JehadMajed/DT_LINE/production_line_vision/data/calibration/calibration_top_view_20260829_140004.jpg

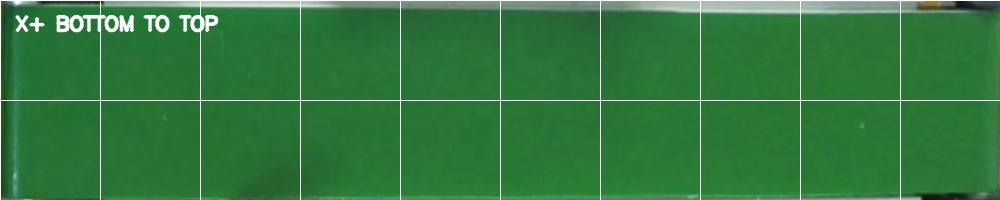
production_line_vision/data/calibration/calibration_top_view_20260829_140004.jpg
