JehadMajed/DT_LINE/Upgrades/Hardware.txt

Awaiting delivery
Date: Jun 27, 2026
Ref. Number: 1121430833916150
Copy
Details

Advanced Tech
Double BTS7960 43A H-bridge High-power Motor Driver module/smart car/
US $4.90   x1
SAR4 coupon if delayed
Free returns
Total:US $4.90
Track status
Awaiting delivery
Date: Jun 27, 2026
Ref. Number: 1121430833896150
Copy
Details

GVMRZ Store
ATC Medium Blade Waterproof Fuse Holder For Automobile 32V 18/16/14/12/10AWG Standard Fuse Insert 1A 2A 3A 4A 5A 7.5A 10A 15A-50
Black, 18AWG, 7.5A
US $2.38   x1
SAR4 coupon if delayed
Free returns
·
Door-to-door delivery
Total:US $2.38
Track status
Awaiting delivery
Date: Jun 27, 2026
Ref. Number: 1121430833876150
Copy
Details

TOP-TECH Store
ESP32 WROOM-32 Development Board WiFi+Bluetooth Ultra-Low Power Consumption for Smart Home IOT Development Board
CH340C Type C
US $6.08   x1
SAR4 coupon if delayed
Free returns
·
Door-to-door delivery
Total:US $6.08
Track status
Awaiting delivery
Date: Jun 27, 2026
Ref. Number: 1121430833856150
Copy
Details
Poder Store
JGB37-555 Miniature DC Deceleration Low Speed Motor Speed Small Motor DC 12V 24V with Speed Measuring Code Disc Encoder
12V With Bracket, 167rpm, Other
US $16.18   x1
SAR4 coupon if delayed
Free returns
Total:US $43.43
Track status
Awaiting delivery
Date: Jun 27, 2026
Ref. Number: 1121430833836150
Copy
Details

Power SMPS Specialty Store
DC 12V Power Supply 12V 5V 6V 8V 9V 12V 13V 15V 24V 1A 2A 3A 4A 5A 6A 7A 8A 10A 220V TO 12V Power Supply Adapter For LED Strips
DC 12V, 5A, EU Plug
US $11.99   x1
SAR4 coupon if delayed
Free returns
Total:US $11.99
Track status
Awaiting delivery
Date: Jun 27, 2026
Ref. Number: 1121430833816150
Copy
Details

KaiHang Electron Store
PC817 2/4/8 Channel Optocoupler Isolation Board Voltage Converter Adapter Module 3.6-30V Driver Photoelectric Isolated Module
PC817 2 Channel
US $2.47   x1
SAR4 coupon if delayed
Free returns
Total:US $2.47
Track status
Awaiting delivery
Date: Jun 27, 2026
Ref. Number: 1121430833796150
Copy
Details

Quality supplier Store
40 / 120pcs 40PIN 20CM Dupont Line Male To Male + Female And Female To Female Jumper Dupont Wire Cable For Arduino DIY KIT IBUW
KIT 120PCS
US $4.74   x1
SAR4 coupon if delayed
Free returns
·
Door-to-door delivery
Total:US $4.74
Track status
Processing
Date: Jun 27, 2026
Ref. Number: 1121430833776150
Copy
Details

Enjoying colourful life Store
Mini Conveyor Belt CNC Processing Desktop Conveyor Belt 10x50CM 555 Gear Motor Reverse with Controller for Assembly Line
US $107.41   x1
SAR4 coupon if delayed
Free returns
·
Door-to-door delivery
Total:US $107.41
Awaiting delivery
Date: Jun 27, 2026
Ref. Number: 1121430833756150
Copy
Details

SNVI Snvi Store Official Store
E3F-DS30C4 Proximity Switch Photoelectric sensor switch NPN PNP DC5-36V 30cm Detection Range Adjustable E3F-DS30P1/P2/C2/Y1
E3F-DS30C4, China Mainland
US $5.03   x1
SAR4 coupon if delayed
Free returns
