JehadMajed/DT_LINE/production_line_vision/data/calibration/baseline_artifacts_20260829_140341.png

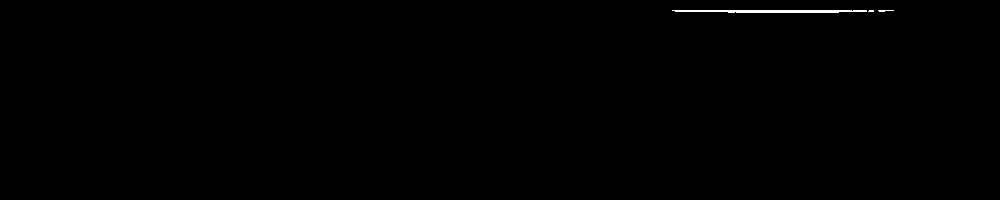
production_line_vision/data/calibration/baseline_artifacts_20260829_140341.png
