JehadMajed/DT_LINE/production_line_vision/data/calibration/baseline_empty_belt_20260829_140341.jpg

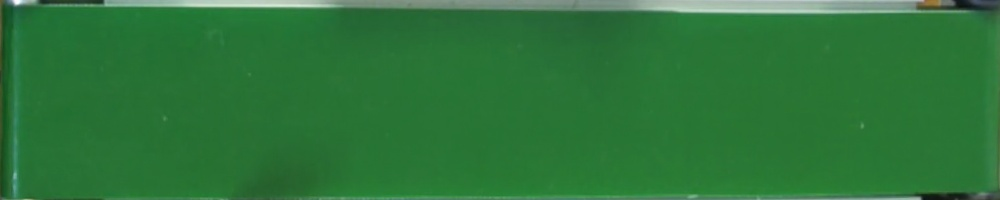
production_line_vision/data/calibration/baseline_empty_belt_20260829_140341.jpg
