JehadMajed/DT_LINE/production_line_vision/data/calibration/baseline_empty_belt_20260829_140940.jpg

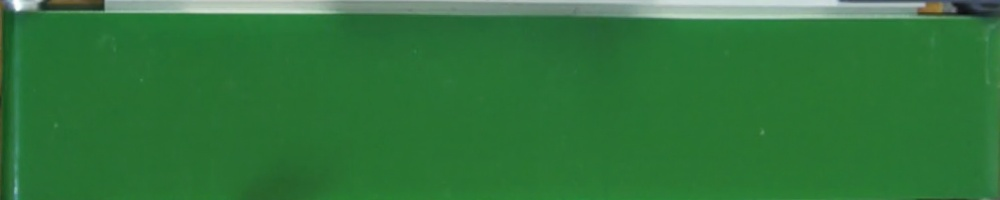
production_line_vision/data/calibration/baseline_empty_belt_20260829_140940.jpg
