JehadMajed/DT_LINE/production_line_vision/data/calibration/calibration_mask_20260829_135900.png

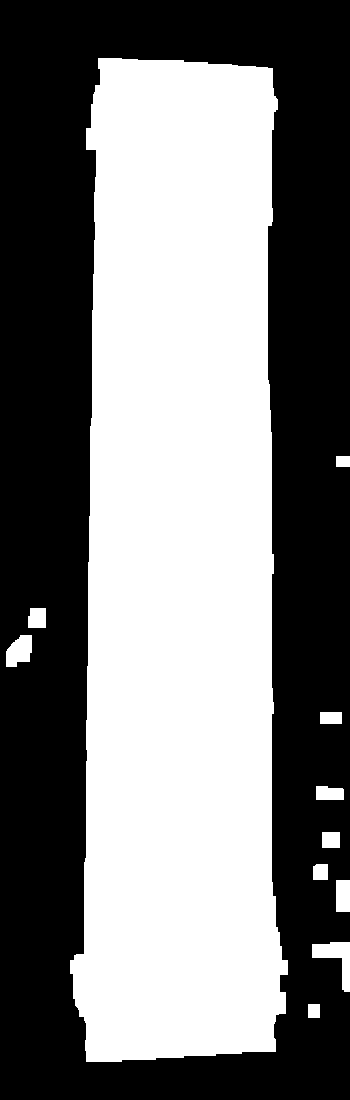
production_line_vision/data/calibration/calibration_mask_20260829_135900.png
