JehadMajed/DT_LINE/production_line_vision/data/calibration/calibration_top_view_20260829_135900.jpg

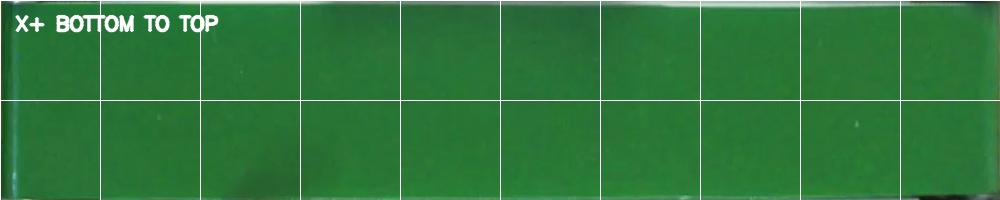
production_line_vision/data/calibration/calibration_top_view_20260829_135900.jpg
