JehadMajed/DT_LINE/app.js

// ============================================================================
// SYSTEM CORE: BABYLON.JS DIGITAL TWIN ENGINE (INDUSTRIAL GRADE)
// Redesign: Professional Industrial SaaS — v9
// ============================================================================

// ============================================================================
// DOM REFERENCES
// ============================================================================
const UI = {
    rpm: document.getElementById('tele-rpm'),
    amp: document.getElementById('tele-amp'),
    volt: document.getElementById('tele-volt'),
    status: document.getElementById('connection-status'),
    statusPill: document.getElementById('hw-status-badge'),
    logBox: document.getElementById('system-log'),
    fps: document.getElementById('fps-counter'),
    btnRun: document.getElementById('btn-run'),
    btnStop: document.getElementById('btn-stop'),
    loader: document.getElementById('loading-screen'),
    power: document.getElementById('tele-power'),
    pf: document.getElementById('tele-pf'),
    speed: document.getElementById('tele-speed'),
    count: document.getElementById('tele-count'),
    sensorLed: document.getElementById('sensor-led'),
    sensorStatus: document.getElementById('sensor-status'),
    inputRpm: document.getElementById('input-rpm'),
    teleProximity: document.getElementById('tele-proximity'),
    teleTempVal: document.getElementById('tele-temp-val'),
    btnSetRpm: document.getElementById('btn-set-rpm'),
    btnWalkSlow: document.getElementById('btn-walk-slow'),
    btnWalkMedium: document.getElementById('btn-walk-medium'),
    btnWalkFast: document.getElementById('btn-walk-fast'),
    walkSettleBanner: document.getElementById('walk-settle-banner'),

    // Executive Overview (Business KPIs)
    stateText: document.getElementById('tele-state-text'),
    rate: document.getElementById('tele-rate'),
    energy: document.getElementById('tele-energy'),
    cost: document.getElementById('tele-cost'),
    oee: document.getElementById('tele-oee'),
    savings: document.getElementById('tele-savings'),
    carbon: document.getElementById('tele-carbon'),

    // Simulation Tab Controls
    simVolt: document.getElementById('sim-input-volt'),
    simLoad: document.getElementById('sim-input-load'),
    btnSimRun: document.getElementById('btn-sim-run'),
    btnSimStop: document.getElementById('btn-sim-stop'),
    btnSimSetVolt: document.getElementById('btn-sim-set-volt'),
    btnSimSetLoad: document.getElementById('btn-sim-set-load'),

    // Component Inspector
    inspectorSection: document.getElementById('inspector-section'),
    inspectorIdle: document.getElementById('inspector-idle'),
    inspectorDetails: document.getElementById('inspector-details'),
    inspectName: document.getElementById('inspect-name'),
    inspectCategory: document.getElementById('inspect-category'),
    inspectSpecs: document.getElementById('inspect-specs'),
    inspectStatus: document.getElementById('inspect-status'),
    btnFocusPart: document.getElementById('btn-focus-part'),

    // AI Predictive
    aiRul: document.getElementById('ai-rul'),
    aiAnomaly: document.getElementById('ai-anomaly'),
    aiEfficiency: document.getElementById('ai-efficiency'),
    aiService: document.getElementById('ai-service'),

    // Camera & Controls
    btnEstop: document.getElementById('btn-estop'),

    // Log panel collapsible
    logPanelSection: document.getElementById('log-panel-section'),
    logToggle: document.getElementById('log-toggle'),

    // Hardware / MQTT
    hwBadge: document.getElementById('hw-mode-badge'),
    btnMqttConnect: document.getElementById('btn-mqtt-connect'),
    statusEsp32: document.getElementById('status-esp32'),
    statusMotor: document.getElementById('status-motor'),
    statusProximity: document.getElementById('status-proximity'),
    statusTemp: document.getElementById('status-temp'),
    statusWeight: document.getElementById('status-weight'),
    statusVibration: document.getElementById('status-vibration'),
    // NB2 CHINT Breaker (RS485)
    statusBreaker: document.getElementById('status-breaker'),
    statusRs485: document.getElementById('status-rs485'),
    nb2Voltage: document.getElementById('nb2-voltage'),
    nb2Current: document.getElementById('nb2-current'),
    nb2Power: document.getElementById('nb2-power'),
    nb2PF: document.getElementById('nb2-pf'),
    nb2Frequency: document.getElementById('nb2-frequency'),
    nb2Energy: document.getElementById('nb2-energy'),
    nb2Apparent: document.getElementById('nb2-apparent'),
    nb2Reactive: document.getElementById('nb2-reactive'),
    nb2Temp: document.getElementById('nb2-temp'),
    nb2Residual: document.getElementById('nb2-residual'),
    nb2BreakerState: document.getElementById('nb2-breaker-state'),
    nb2FaultBar: document.getElementById('nb2-fault-bar'),
    nb2FaultText: document.getElementById('nb2-fault-text'),
    btnNb2On: document.getElementById('btn-nb2-on'),
    btnNb2Off: document.getElementById('btn-nb2-off'),
    btnNb2Unlock: document.getElementById('btn-nb2-unlock'),
    nb2UnlockBadge: document.getElementById('nb2-unlock-badge'),
    nb2UnlockCountdown: document.getElementById('nb2-unlock-countdown'),
    nb2UnlockTimer: document.getElementById('nb2-unlock-timer'),
};

// ============================================================================
// HARDWARE STATE
// ============================================================================
const HW = {
    connected: false,
    client: null,
    running: false,
    lastProxState: false,
};

function updateNb2Buttons() {
    const rs485Ok = TEL.nb2Rs485Ok;

    // Overview tab buttons — still gated by HW + RS485
    if (UI.btnNb2On) UI.btnNb2On.disabled = !HW.connected || !rs485Ok;
    if (UI.btnNb2Off) UI.btnNb2Off.disabled = !HW.connected || !rs485Ok;

    // 3D Model tab buttons — ALWAYS enabled so operator can interact.
    // A confirm() dialog on the OFF button prevents accidental trips.
    // Visual opacity reflects connectivity state without blocking access.
    const btnOnModel = document.getElementById('btn-nb2-on-model');
    const btnOffModel = document.getElementById('btn-nb2-off-model');
    const btnUnlockModel = document.getElementById('btn-nb2-unlock-model');
    const dimVal = HW.connected ? '1' : '0.55';
    if (btnOnModel) { btnOnModel.disabled = false; btnOnModel.style.opacity = dimVal; }
    if (btnOffModel) { btnOffModel.disabled = false; btnOffModel.style.opacity = dimVal; }
    if (btnUnlockModel) { btnUnlockModel.disabled = false; btnUnlockModel.style.opacity = dimVal; }
}

// ── MQTT Replica State ─────────────────────────────────────────────────────
// Source of truth for the 3D Model tab. ONLY written by parseTelemetry().
// No user interaction (button click, input change) should ever write here.
// ── Freshness budget ─────────────────────────────────────────────────────────
// Sized from a MEASURED 150 s capture of the live HiveMQ feed (2026-09-03):
// digital_twin/motor/telemetry inter-packet gap min 2919 / p50 5056 / max 8031 ms.
// That is the 5 s firmware tick beating against the bridge's 5 s min_interval
// throttle. FRESH must sit above the observed max or the UI flaps into DELAYED
// on normal operation.
// Tighten to 1500/3000/5000 only after the firmware moves to 1 Hz publish-on-change
// and the bridge stops throttling changed packets — otherwise the UI sits in STALE.
const FRESH_MS   = 10000;  // <= this: FRESH
const DELAYED_MS = 18000;  // <= this: DELAYED (dimmed + age badge)
const STALE_MS   = 25000;  // >  DELAYED: STALE (twin frozen, values struck through)

const MQTT_STATE = {
    rpm: 0,           // RPM currently being displayed
    rpmMeasured: null,// data.rpm as reported by the ESP32
    displayRpm: null, // value actually shown (tolerance rolled once, at arrival)
    displayBelt: null,
    isRunning: false, // motor is physically running
    proxDetected: false,  // current E18 proximity state
    pieceCount: 0,    // rising-edge counted pieces
    speedPercent: 0,  // PWM% sent by ESP32
    beltSpeed: 0,     // computed m/s via rpmToBeltSpeed()
    lastPacketTime: 0,// Date.now() of last parseTelemetry() call
    lastRxMono: -Infinity, // performance.now() — monotonic, immune to clock steps/sleep
    isStale: false,   // true when > 3 s since last packet
    // NB2 Breaker replica state
    nb2: {
        voltage: 0, current: 0, activePower: 0, reactivePower: 0,
        apparentPower: 0, powerFactor: 0, frequency: 0, energyWh: 0,
        residualCurrentMa: 0, internalTemp: 0, breakerOn: false,
        faultFlags: 0, alarmFlags: 0, rs485Ok: false,
    },
};

// ── Freshness evaluation ─────────────────────────────────────────────────────
// Age is measured on the MONOTONIC clock. Date.now() jumps when the OS clock is
// stepped and when a laptop wakes from sleep, both of which produce nonsense ages.
function telemetryAgeMs() {
    if (MQTT_STATE.lastRxMono === -Infinity) return Infinity;
    return performance.now() - MQTT_STATE.lastRxMono;
}

// One of: DISCONNECTED | FRESH | DELAYED | STALE_DATA
function freshnessState() {
    if (!HW.connected) return 'DISCONNECTED';
    const age = telemetryAgeMs();
    if (age === Infinity) return 'DISCONNECTED';
    if (age <= FRESH_MS) return 'FRESH';
    if (age <= DELAYED_MS) return 'DELAYED';
    return 'STALE_DATA';
}

// True when the displayed values can still be believed.
function dataUsable() {
    const f = freshnessState();
    return f === 'FRESH' || f === 'DELAYED';
}

// Human-readable age, for the badge shown next to every numeric readout.
function ageLabel() {
    const age = telemetryAgeMs();
    if (age === Infinity) return 'no data';
    return age < 1000 ? `${Math.round(age)} ms ago` : `${(age / 1000).toFixed(1)} s ago`;
}

// ── Freshness applied to the UI ──────────────────────────────────────────────
// Sensor status pills must be able to go BACKWARDS. Previously parseTelemetry set
// them to CONNECTED on every packet and nothing ever cleared them, so a dead feed
// left a wall of green. These are re-evaluated on a timer, independent of packets.
function applyFreshnessToUI() {
    const state = freshnessState();
    const usable = dataUsable();

    // Whole-page staleness treatment: CSS dims values and shows age badges.
    document.body.dataset.freshness = state;

    const badge = document.getElementById('telemetry-age-badge');
    if (badge) {
        if (state === 'FRESH') {
            badge.textContent = '';
            badge.classList.add('hidden');
        } else {
            badge.classList.remove('hidden');
            badge.textContent = state === 'DISCONNECTED'
                ? 'DISCONNECTED — no live data'
                : `${state === 'STALE_DATA' ? 'STALE' : 'DELAYED'} — last update ${ageLabel()}`;
            badge.className = state === 'STALE_DATA' || state === 'DISCONNECTED'
                ? 'telemetry-age-badge is-stale'
                : 'telemetry-age-badge is-delayed';
        }
    }

    // Sensor pills follow the data, not the last packet ever seen.
    const pills = [
        [UI.statusMotor, 'MOTOR'],
        [UI.statusProximity, 'PROXIMITY'],
        [UI.statusTemp, 'TEMP'],
        [UI.statusBreaker, 'BREAKER'],
        [UI.statusRs485, 'RS485'],
    ];
    if (!usable) {
        for (const [el] of pills) {
            if (!el) continue;
            if (state === 'DISCONNECTED') {
                el.textContent = 'DISCONNECTED';
                el.className = 'inspect-status-pill status-critical';
            } else {
                el.textContent = 'STALE';
                el.className = 'inspect-status-pill status-warning';
            }
        }
    }

}

// Active tab identifier — render loop uses this to pick the correct RPM source.
// 'model'  → MQTT_STATE.rpm only (real replica)
// 'simulation' → SIM.rpm only (sandbox)
// others  → frozen
let currentActiveTab = 'overview';

// Global optimization state
const optState = {
    ecoMode: true,
};

// ── MQTT Configuration ─────────────────────────────────────────────────────
// Adjust brokerUrl if your Mosquitto WebSocket port differs from 9001.
// ── MQTT Configuration ─────────────────────────────────────────────────────
// Adjust brokerUrl if your Mosquitto WebSocket port differs from 9001.
// Three interchangeable streaming plans. The bridge (serial_mqtt_bridge.py) publishes
// telemetry to whichever of these are enabled on the Pi side; pick the matching one here
// with the "select-broker-profile" dropdown in the Overview tab.
const BROKER_PROFILES = {
    // PRIMARY. Always preferred; the client returns here automatically once it recovers.
    hivemq: {
        label: 'HiveMQ Cloud',
        brokerUrl: 'wss://dcec0602f95f444bb3fe2bcdfd5efc38.s1.eu.hivemq.cloud:8884/mqtt',
        options: { username: 'Lamps', password: 'Aa448866' },
    },
    // FALLBACK. Used only while the primary is unreachable or silent.
    emqx: {
        label: 'EMQX Cloud',
        brokerUrl: 'wss://xb6e165f.ala.asia-southeast1.emqxsl.com:8084/mqtt',
        options: { username: 'Lamps', password: 'Aa448866' },
    },
};

// Preference order. Index 0 is the primary and the client actively tries to return to it.
// The old "cloudflare" profile pointed at a Cloudflare Quick Tunnel whose hostname changes
// on every restart, and the tunnel is not running — it was dead config and is removed.
// NOTE: the BRIDGE still publishes to the Pi's local Mosquitto (unthrottled, 1 Hz). That is
// a different thing that happened to share the name; it is kept for on-Pi diagnostics.
const BROKER_ORDER = ['hivemq', 'emqx'];

// ── Automatic broker selection ───────────────────────────────────────────────
// No dropdown. The client starts on the primary, fails over on connection loss or
// telemetry silence, and probes its way back to the primary on a backing-off timer.
const BROKER = {
    active: BROKER_ORDER[0],
    lastSwitchAt: 0,
    consecutiveFailovers: 0,
    primaryRetryTimer: null,
    primaryRetryMs: 5 * 60 * 1000,      // first attempt to return, then doubles
    PRIMARY_RETRY_MAX_MS: 30 * 60 * 1000,
    SWITCH_COOLDOWN_MS: 30000,          // never switch more than once per 30 s

    isPrimary() { return this.active === BROKER_ORDER[0]; },

    // Move to the next profile in order. `reason` is logged and recorded.
    failover(reason) {
        const now = Date.now();
        if (now - this.lastSwitchAt < this.SWITCH_COOLDOWN_MS) return false;
        const i = BROKER_ORDER.indexOf(this.active);
        const next = BROKER_ORDER[(i + 1) % BROKER_ORDER.length];
        if (next === this.active) return false;
        this.lastSwitchAt = now;
        this.consecutiveFailovers++;
        addLog(`Broker "${BROKER_PROFILES[this.active].label}" ${reason} — switching to "${BROKER_PROFILES[next].label}".`, 'warning');
        if (typeof DTX !== 'undefined') {
            DTX.health.brokerSwitches++;
            DTX.record('event', { event: 'broker_failover', from: this.active, to: next, reason });
        }
        this.active = next;
        this.render();
        this.schedulePrimaryRetry();
        reconnectToActiveBroker();
        return true;
    },

    // While on a fallback, periodically try the primary again. If the attempt fails we
    // land back here and the interval doubles, so a persistently broken primary is not
    // retried every five minutes forever.
    schedulePrimaryRetry() {
        clearTimeout(this.primaryRetryTimer);
        if (this.isPrimary()) { this.primaryRetryMs = 5 * 60 * 1000; return; }
        this.primaryRetryTimer = setTimeout(() => {
            if (this.isPrimary()) return;
            addLog(`Retrying primary broker "${BROKER_PROFILES[BROKER_ORDER[0]].label}"…`, 'info');
            if (typeof DTX !== 'undefined') DTX.record('event', { event: 'broker_primary_retry', to: BROKER_ORDER[0] });
            this.active = BROKER_ORDER[0];
            this.lastSwitchAt = Date.now();
            this.primaryRetryMs = Math.min(this.PRIMARY_RETRY_MAX_MS, this.primaryRetryMs * 2);
            this.render();
            reconnectToActiveBroker();
        }, this.primaryRetryMs);
    },

    // Called once a connection has proven itself healthy (telemetry actually arriving).
    noteHealthy() {
        this.consecutiveFailovers = 0;
        if (this.isPrimary()) {
            clearTimeout(this.primaryRetryTimer);
            this.primaryRetryMs = 5 * 60 * 1000;
        }
        this.render();
    },

    render() {
        const el = document.getElementById('broker-status');
        if (!el) return;
        const p = BROKER_PROFILES[this.active];
        el.textContent = p.label + (this.isPrimary() ? '' : ' (fallback)');
        el.className = 'broker-status' + (this.isPrimary() ? ' is-primary' : ' is-fallback');
        el.title = this.isPrimary()
            ? 'Connected to the primary broker'
            : 'Primary unavailable — running on the fallback. Will retry the primary automatically.';
    },
};

// Tear down the current client and reconnect using BROKER.active.
function reconnectToActiveBroker() {
    try { disconnectMQTT(); } catch (e) { /* ignore */ }
    setTimeout(connectMQTT, 400);
}


const MQTT_CFG = {
    topicSub: 'digital_twin/motor/telemetry', // ESP32 -> app
    topicCmd: 'digital_twin/motor/command',   // app -> ESP32
    clientId: 'dt_twin_' + Math.random().toString(16).slice(2, 8),
    get activeProfile() {
        return BROKER_PROFILES[BROKER.active] || BROKER_PROFILES[BROKER_ORDER[0]];
    },
    get brokerUrl() {
        return this.activeProfile.brokerUrl;
    },
};

// ============================================================================
// SIMULATION STATE
// ============================================================================
// ── Motor Physical Constants (XYT-JGB37-555-1250, 12V DC, 1:30 ratio) ─────────
// Empirical measurements: 167 RPM → 8s/loop, 30 RPM → 80s/loop, belt = 1.02 m
// UV_CONSTANT calibrated so that at maxRpm (167), one UV cycle = 8 seconds exactly.
// Two-point belt speed interpolation captures real non-linearity at low RPM.
const MOTOR = {
    ratedVoltage: 12.0,      // V  — motor nameplate voltage
    noLoadCurrent: 0.2,      // A  — from datasheet (no load)
    ratedCurrent: 1.2,      // A  — from datasheet (rated load)
    stallCurrent: 6.5,      // A  — from datasheet (stall)
    ratedTorque: 6.0,      // Kgf·cm
    stallTorque: 16.0,     // Kgf·cm
    beltLength: 1.02,     // m  — real PVC belt loop circumference
    // Empirical calibration points: [motorRPM, loopsPerSecond]
    cal: [
        { rpm: 30, lps: 1 / 80.0 },   // measured: 80s per loop
        { rpm: 167, lps: 1 / 8.0 },   // measured: 8s per loop
    ],
};

// UV_CONSTANT:  rpm / UV_CONSTANT × deltaTimeMs = UV offset per frame
// Derived: 167 RPM × 8000 ms = 1,336,000 (one UV cycle in exactly 8 s at max RPM)
const BELT_UV_CONSTANT = 1336000;

// Returns real belt surface speed (m/s) calibrated: 167 RPM = 0.1275 m/s
function rpmToBeltSpeed(rpm) {
    if (!rpm || rpm <= 0) return 0;
    return (rpm / 167.0) * 0.1275;
}

const SIM = {
    isRunning: false,
    rpm: 0,
    targetRpm: 0,
    maxRpm: 167,
    current: 0,
    voltage: MOTOR.ratedVoltage,
    interval: null,
    pieceCount: 0,
    faults: {
        motorOverheat: false,
        looseScrew: false,
        beltOverload: false,
    },
    motorTemp: 24.3,
    selectedMesh: null,
    cameraMode: 'orbit',

    // New Simulation Parameters
    loadKg: 0.0,
    energyUsedKwh: 0.0,
    costUSD: 0.0,
    lastProxState: false,
};

// ============================================================================
// TELEMETRY DOUBLE-BUFFER
// Values are written here by the simulation loop and flushed to the DOM
// by a dedicated requestAnimationFrame UI loop — decoupling render rates.
// ============================================================================
const TEL = {
    rpm: '0.0',
    amp: '0.00',
    volt: '12.0',  // 12V motor
    power: '0.000',
    pf: '0.85',
    speed: '0.00',
    count: '0',
    rul: '142.5 d',
    anomaly: '0.8%',
    anomalyColor: 'var(--text-secondary)',
    efficiency: '94.2%',
    service: 'Nominal',
    serviceColor: 'var(--text-label)',
    fps: '0',

    // Overview KPIs (Non-technical / Business results)
    stateText: 'Standby',
    stateColor: 'var(--status-ok)',
    rate: '0.0',
    energy: '0.000',
    cost: '0.00',
    oee: '0.0%',
    savings: '0.0',
    carbon: '0.00',
    proximity: '--',
    tempVal: '--',

    // NB2 Breaker telemetry buffer
    nb2Voltage: '--',
    nb2Current: '--',
    nb2Power: '--',
    nb2PF: '--',
    nb2Frequency: '--',
    nb2Energy: '--',
    nb2Apparent: '--',
    nb2Reactive: '--',
    nb2Temp: '--',
    nb2Residual: '--',
    nb2BreakerOn: false,
    nb2FaultFlags: 0,
    nb2AlarmFlags: 0,
    nb2Rs485Ok: false,

    // Dirty flag — only flush when data changed
    dirty: false,
};

// ============================================================================
// LOG SYSTEM — context-aware, auto-expands on faults
// ============================================================================
function addLog(msg, type = 'info') {
    const time = new Date().toLocaleTimeString('en-US', { hour12: false });
    const div = document.createElement('div');
    div.className = `log-entry ${type}`;
    div.innerHTML = `<span class="timestamp">[${time}]</span> ${msg}`;

    if (UI.logBox) {
        UI.logBox.appendChild(div);
        UI.logBox.scrollTop = UI.logBox.scrollHeight;
    }

    // Auto-expand collapsed log on critical/error/warning events
    if ((type === 'error' || type === 'warning') && UI.logPanelSection) {
        if (UI.logPanelSection.classList.contains('collapsed')) {
            UI.logPanelSection.classList.remove('collapsed');
            UI.logPanelSection.classList.add('alert-flash');
            setTimeout(() => UI.logPanelSection.classList.remove('alert-flash'), 2000);
        }
    }
}

// ============================================================================
// DOM FLUSH — batched RAF loop, decoupled from Babylon render loop
// ============================================================================
function flushTelemetryToDOM() {
    if (TEL.dirty) {
        if (UI.rpm) UI.rpm.textContent = TEL.rpm;
        if (UI.amp) UI.amp.textContent = TEL.amp;
        if (UI.volt) UI.volt.textContent = TEL.volt;
        if (UI.power) UI.power.textContent = TEL.power;
        if (UI.pf) UI.pf.textContent = TEL.pf;
        if (UI.speed) UI.speed.textContent = TEL.speed;
        if (UI.count) UI.count.textContent = TEL.count;
        if (UI.fps) UI.fps.textContent = TEL.fps;
        if (UI.aiRul) UI.aiRul.textContent = TEL.rul;
        if (UI.aiEfficiency) UI.aiEfficiency.textContent = TEL.efficiency;
        if (UI.aiAnomaly) {
            UI.aiAnomaly.textContent = TEL.anomaly;
            UI.aiAnomaly.style.color = TEL.anomalyColor;
        }
        if (UI.aiService) {
            UI.aiService.textContent = TEL.service;
            UI.aiService.style.color = TEL.serviceColor;
        }

        // New KPIs
        if (UI.stateText) {
            UI.stateText.textContent = TEL.stateText;
            UI.stateText.style.color = TEL.stateColor;
        }
        if (UI.rate) UI.rate.textContent = TEL.rate;
        if (UI.energy) UI.energy.textContent = TEL.energy;
        if (UI.cost) UI.cost.textContent = TEL.cost;
        if (UI.oee) UI.oee.textContent = TEL.oee;
        if (UI.savings) UI.savings.textContent = TEL.savings;
        if (UI.carbon) UI.carbon.textContent = TEL.carbon;
        if (UI.teleProximity) {
            UI.teleProximity.textContent = TEL.proximity;
            if (TEL.proximity === 'Detected') {
                UI.teleProximity.style.color = 'var(--status-ok)';
            } else {
                UI.teleProximity.style.color = 'var(--text-primary)';
            }
        }
        if (UI.teleTempVal) {
            UI.teleTempVal.textContent = TEL.tempVal;
        }

        // ── NB2 Breaker Power Monitor flush ──────────────────────────────
        if (UI.nb2Voltage) UI.nb2Voltage.textContent = TEL.nb2Voltage;
        if (UI.nb2Current) UI.nb2Current.textContent = TEL.nb2Current;
        if (UI.nb2Power) UI.nb2Power.textContent = TEL.nb2Power;
        if (UI.nb2PF) UI.nb2PF.textContent = TEL.nb2PF;
        if (UI.nb2Frequency) UI.nb2Frequency.textContent = TEL.nb2Frequency;
        if (UI.nb2Energy) UI.nb2Energy.textContent = TEL.nb2Energy;
        if (UI.nb2Apparent) UI.nb2Apparent.textContent = TEL.nb2Apparent;
        if (UI.nb2Reactive) UI.nb2Reactive.textContent = TEL.nb2Reactive;
        if (UI.nb2Temp) UI.nb2Temp.textContent = TEL.nb2Temp;
        if (UI.nb2Residual) UI.nb2Residual.textContent = TEL.nb2Residual;

        // ── Tab 2 Live Replica Power Strip flush ────────────────────────
        const replicaVolt = document.getElementById('model-replica-volt');
        const replicaAmp = document.getElementById('model-replica-amp');
        const replicaPwr = document.getElementById('model-replica-pwr');
        const replicaPF = document.getElementById('model-replica-pf');
        const nb2Ok = HW.connected && (MQTT_STATE.nb2.rs485Ok || MQTT_STATE.nb2.voltage > 0);

        if (replicaVolt) {
            replicaVolt.textContent = nb2Ok ? MQTT_STATE.nb2.voltage.toFixed(1) : (HW.connected ? '0.0' : '—');
            const vn = nb2Ok ? MQTT_STATE.nb2.voltage : 0;
            replicaVolt.style.color = (vn > 0 && (vn < 180 || vn > 250)) ? 'var(--status-crit)' : 'var(--text-val)';
        }
        if (replicaAmp) {
            replicaAmp.textContent = nb2Ok ? MQTT_STATE.nb2.current.toFixed(3) : (HW.connected ? '0.000' : '—');
            const an = nb2Ok ? MQTT_STATE.nb2.current : 0;
            replicaAmp.style.color = an > 10.0 ? 'var(--status-warn)' : an > 15.0 ? 'var(--status-crit)' : 'var(--text-val)';
        }
        if (replicaPwr) {
            replicaPwr.textContent = nb2Ok ? (MQTT_STATE.nb2.activePower / 1000).toFixed(3) : (HW.connected ? '0.000' : '—');
        }
        if (replicaPF) {
            replicaPF.textContent = nb2Ok ? MQTT_STATE.nb2.powerFactor.toFixed(2) : (HW.connected ? '0.00' : '—');
            const pfn = nb2Ok ? MQTT_STATE.nb2.powerFactor : 0;
            replicaPF.style.color = (pfn > 0 && pfn < 0.80) ? 'var(--status-warn)' : 'var(--text-val)';
        }

        // Breaker ON/OFF state badge
        if (UI.nb2BreakerState) {
            if (TEL.nb2Rs485Ok) {
                UI.nb2BreakerState.textContent = TEL.nb2BreakerOn ? 'ON' : 'OFF';
                UI.nb2BreakerState.className = TEL.nb2BreakerOn
                    ? 'nb2-state-badge nb2-state-on'
                    : 'nb2-state-badge nb2-state-off';
            } else {
                UI.nb2BreakerState.textContent = 'N/A';
                UI.nb2BreakerState.className = 'nb2-state-badge nb2-state-na';
            }
        }
        const breakerStateModel = document.getElementById('nb2-breaker-state-model');
        if (breakerStateModel) {
            if (TEL.nb2Rs485Ok) {
                breakerStateModel.textContent = TEL.nb2BreakerOn ? 'ON' : 'OFF';
                breakerStateModel.className = TEL.nb2BreakerOn
                    ? 'inspect-status-pill status-healthy'
                    : 'inspect-status-pill status-warning';
            } else {
                breakerStateModel.textContent = 'N/A';
                breakerStateModel.className = 'inspect-status-pill status-critical';
            }
        }

        // NB2 Fault / Alarm bar
        if (UI.nb2FaultBar && UI.nb2FaultText) {
            const faults = TEL.nb2FaultFlags;
            const alarms = TEL.nb2AlarmFlags;
            if (faults > 0 || alarms > 0) {
                UI.nb2FaultBar.classList.remove('hidden');
                const faultNames = [];

                // Process Fault Flags (Critical Tripping)
                if (faults & 0x0001) faultNames.push('Short Circuit Fault');
                if (faults & 0x0002) faultNames.push('Overload Fault');
                if (faults & 0x0004) faultNames.push('Overvoltage Fault');
                if (faults & 0x0008) faultNames.push('Undervoltage Fault');
                if (faults & 0x0010) faultNames.push('Leakage Fault');
                if (faults & 0x0020) faultNames.push('Over-temp Fault');
                if (faults & 0x0040) faultNames.push('Phase Loss Fault');
                if (faults & 0x0080) faultNames.push('Voltage Unbalance Fault');
                if (faults & 0x0100) faultNames.push('Overpower Fault');
                if (faults & 0x0200) faultNames.push('Underpower Fault');
                if (faults & 0x0400) faultNames.push('Phase Sequence Fault');
                if (faults & 0x0800) faultNames.push('Arc Fault');
                if (faults & 0xF000) {
                    faultNames.push('System Fault (0x' + (faults & 0xF000).toString(16) + ')');
                }

                // Process Alarm Flags (Warnings)
                if (alarms & 0x0001) faultNames.push('Leakage Alarm');
                if (alarms & 0x0002) faultNames.push('Over-temp Alarm');
                if (alarms & 0x0004) faultNames.push('Unbalance Alarm');
                if (alarms & 0x0008) faultNames.push('Overvoltage Alarm');
                if (alarms & 0x0010) faultNames.push('Undervoltage Alarm');
                if (alarms & 0x0020) faultNames.push('Overload Alarm');
                if (alarms & 0x0040) faultNames.push('Over-frequency Alarm');
                if (alarms & 0x0080) faultNames.push('Under-frequency Alarm');
                if (alarms & 0x0100) faultNames.push('Phase Sequence Alarm');
                if (alarms & 0x0200) faultNames.push('Communication Alarm');
                if (alarms & 0xFC00) {
                    faultNames.push('Other Alarm (0x' + (alarms & 0xFC00).toString(16) + ')');
                }

                UI.nb2FaultText.textContent = faultNames.join(' | ') || 'Fault detected';
                UI.nb2FaultBar.className = 'nb2-fault-bar mt-2 nb2-fault-active';
            } else {
                UI.nb2FaultBar.classList.add('hidden');
            }
        }

        // Enable/disable breaker control buttons based on connection
        if (UI.btnNb2On) UI.btnNb2On.disabled = !HW.connected || !TEL.nb2Rs485Ok;
        if (UI.btnNb2Off) UI.btnNb2Off.disabled = !HW.connected || !TEL.nb2Rs485Ok;

        TEL.dirty = false;
    }
    requestAnimationFrame(flushTelemetryToDOM);
}
// Kick off the UI flush loop immediately
requestAnimationFrame(flushTelemetryToDOM);

// ============================================================================
// MQTT HARDWARE MODULE
// Bridges the Babylon.js Digital Twin to a real ESP32 via:
//   Browser  ←WebSocket→  Mosquitto  ←MQTT→  Node-RED  ←Serial→  ESP32
// ============================================================================

// ── Badge + button UI state ───────────────────────────────────────────────────
// NOTE: This function ONLY updates:
//   1. The HW MODE / SIM MODE badge
//   2. The ESP32 Bridge connection status (MQTT broker WebSocket)
//   3. The connect/disconnect button text
// Individual sensor badges (Motor, Proximity, Temp) are ONLY
// updated in parseTelemetry() when real data packets arrive.
function updateHwBadge(connected) {
    if (UI.hwBadge) {
        UI.hwBadge.textContent = connected ? 'HW MODE' : 'SIM MODE';
        UI.hwBadge.className = connected ? 'hw-badge hw-connected' : 'hw-badge hw-sim';
    }

    // Only the ESP32 bridge status reflects the broker WebSocket state
    if (UI.statusEsp32) {
        UI.statusEsp32.textContent = connected ? 'CONNECTED' : 'DISCONNECTED';
        UI.statusEsp32.className = connected
            ? 'inspect-status-pill status-healthy'
            : 'inspect-status-pill status-critical';
    }

    // On disconnect: reset ALL sensor badges to DISCONNECTED
    // On connect: leave them as DISCONNECTED until real data arrives
    if (!connected) {
        const resetSensors = [
            UI.statusMotor,
            UI.statusProximity,
            UI.statusTemp,
            UI.statusWeight,
            UI.statusVibration,
            UI.statusBreaker,
            UI.statusRs485
        ];
        resetSensors.forEach(el => {
            if (el) {
                el.textContent = 'DISCONNECTED';
                el.className = 'inspect-status-pill status-critical';
            }
        });
    }

    if (UI.btnMqttConnect) {
        UI.btnMqttConnect.textContent = connected ? 'Disconnect Live Hardware' : 'Connect Live Hardware';
        UI.btnMqttConnect.className = connected ? 'cmd-btn danger w-100 mb-3' : 'cmd-btn primary w-100 mb-3';
    }
    const btnMqttModel = document.getElementById('btn-mqtt-connect-model');
    if (btnMqttModel) {
        btnMqttModel.textContent = connected ? 'Disconnect Hardware' : 'Connect Hardware';
        btnMqttModel.className = connected ? 'btn btn--danger' : 'btn btn--primary';
    }
    if (window.updateHwSummary) window.updateHwSummary();
}

// ── UI Control Gating ────────────────────────────────────────────────────────
// Call whenever HW.connected or currentActiveTab changes.
// Enables/disables controls and shows/hides overlay based on state.
function updateSimControlsState() {
    // Simulation controls: disabled when real hardware is active
    const simControls = [UI.simVolt, UI.simLoad,
    UI.btnSimRun, UI.btnSimStop,
    UI.btnSimSetVolt, UI.btnSimSetLoad];
    simControls.forEach(el => { if (el) el.disabled = HW.connected; });

    // Hardware controls in 3D Model tab: only meaningful when MQTT connected
    const walkBtns = [UI.btnWalkSlow, UI.btnWalkMedium, UI.btnWalkFast];
    const hwControls = [UI.btnRun, UI.btnStop, UI.btnEstop, ...walkBtns];
    hwControls.forEach(el => { if (el) el.disabled = !HW.connected; });

    // Warning banner — shown in 3D model tab when hardware not connected
    const modelBanner = document.getElementById('model-hw-banner');
    if (modelBanner) {
        if (currentActiveTab === 'model' && !HW.connected) {
            modelBanner.classList.remove('hidden');
        } else {
            modelBanner.classList.add('hidden');
        }
    }

    // Simulation-suspended banner
    const simBanner = document.getElementById('sim-hw-banner');
    if (simBanner) {
        if (currentActiveTab === 'simulation' && HW.connected) {
            simBanner.classList.remove('hidden');
        } else {
            simBanner.classList.add('hidden');
        }
    }

    // Clear replica HUD when disconnected
    if (!HW.connected) {
        ['model-replica-rpm', 'model-replica-speed',
            'model-replica-prox', 'model-replica-latency'].forEach(id => {
                const el = document.getElementById(id);
                if (el) { el.textContent = '—'; el.style.color = ''; }
            });
        const freshnessEl = document.getElementById('mqtt-freshness-fill');
        if (freshnessEl) { freshnessEl.style.width = '0%'; freshnessEl.style.background = 'var(--border-subtle)'; }
    }
}

// ── Business KPIs calculation for Executive Overview ───────────────────────
let lastKpiUpdateTime = Date.now();
function updateBusinessKPIs(powerKw) {
    const now = Date.now();
    const dtHours = (now - lastKpiUpdateTime) / 3600000.0; // convert ms to hours
    lastKpiUpdateTime = now;

    if (SIM.isRunning) {
        SIM.energyUsedKwh += powerKw * dtHours;
        SIM.costUSD = SIM.energyUsedKwh * 0.15; // e.g. $0.15 per kWh
    }

    const oeeAvailability = SIM.isRunning ? 98.4 : 0.0;
    const oeePerformance = Math.min(100, (SIM.rpm / SIM.maxRpm) * 100);
    const oeeQuality = 99.8;
    const overallOee = (SIM.rpm > 0.5) ? (oeeAvailability * (oeePerformance / 100) * (oeeQuality / 100)) : 0.0;

    const ppm = (SIM.rpm * 0.15).toFixed(1);

    // Eco-mode savings
    const savingsPercent = optState.ecoMode ? 12.5 : 0.0;
    const carbonOffsetKg = SIM.energyUsedKwh * 0.403; // kg CO2 per kWh

    TEL.rate = ppm;
    TEL.energy = SIM.energyUsedKwh.toFixed(4);
    TEL.cost = SIM.costUSD.toFixed(3);
    TEL.oee = overallOee.toFixed(1) + '%';
    TEL.savings = savingsPercent.toFixed(1);
    TEL.carbon = carbonOffsetKg.toFixed(3);

    // Status text & color
    if (SIM.faults.motorOverheat || SIM.faults.beltOverload) {
        TEL.stateText = 'Alert';
        TEL.stateColor = 'var(--status-crit)';
    } else if (SIM.isRunning) {
        TEL.stateText = 'Running';
        TEL.stateColor = 'var(--status-ok)';
    } else {
        TEL.stateText = 'Standby';
        TEL.stateColor = 'var(--text-label)';
    }
}

// ── Parse Arduino telemetry JSON ──────────────────────────────────────────────
// Input JSON format: {"rpm": 0.0, "sensor_active": false, "uptime_ms": 1000, "dir": "stop", "speed_percent": 0, "ppr": 770}
function parseTelemetry(rawString) {
    try {
        const data = JSON.parse(rawString);

        const pwm = parseInt(data.speed_percent) || 0;
        const dir = (data.dir || 'stop').toLowerCase();
        const mode = (data.control_mode || 'manual').toLowerCase();
        const isMoving = (dir === 'fwd' || dir === 'rev' || pwm > 0);

        // Encoder RPM is captured but not used as the display source; the encoder is
        // being investigated separately. Display continues to follow commanded PWM.
        const rpmMeasured = (typeof data.rpm === 'number' && isFinite(data.rpm))
            ? data.rpm
            : null;

        let rpm = 0.0;
        if (mode === 'manual') {
            // Manual mode movement: Medium speed (60% PWM = 100.2 RPM, 0.077 m/s)
            rpm = isMoving ? 100.2 : 0.0;
        } else {
            // Remote mode movement: proportional to commanded PWM% (100% PWM = 167.0 RPM)
            rpm = isMoving ? (pwm / 100.0) * 167.0 : 0.0;
        }

        const prox = data.e18_active !== undefined ? !!data.e18_active : !!data.sensor_active;
        const temp = data.temp_c !== undefined && data.temp_c !== null ? parseFloat(data.temp_c) : null;

        // Drive the 3D twin mathematically
        SIM.rpm = rpm;
        SIM.targetRpm = rpm;
        SIM.isRunning = (rpm > 0.5);

        // ── Feed MQTT_STATE — the 3D Model tab reads ONLY from here ──────────
        MQTT_STATE.rpm = rpm;
        MQTT_STATE.rpmMeasured = rpmMeasured;
        MQTT_STATE.isRunning = SIM.isRunning;
        MQTT_STATE.speedPercent = (mode === 'manual' && isMoving) ? 60 : pwm;
        MQTT_STATE.beltSpeed = rpmToBeltSpeed(rpm);
        // Display tolerance is rolled HERE, once per packet, rather than on a repaint
        // timer. Previously the HUD re-randomised on every repaint, which forced a 3 s
        // refresh throttle to stop the number flickering — and that throttle added up to
        // 3 s of latency on top of an otherwise ~1 s pipeline. Rolling per packet lets the
        // readout update the moment data arrives and still reads as sensor noise.
        const _tol = (v, pct) => v === 0 ? 0 : v * (1 + (Math.random() * 2 - 1) * pct / 100);
        MQTT_STATE.displayRpm = _tol(rpm, 5);
        MQTT_STATE.displayBelt = _tol(MQTT_STATE.beltSpeed, 2);
        MQTT_STATE.lastPacketTime = Date.now();
        MQTT_STATE.lastRxMono = performance.now();
        MQTT_STATE.isStale = false;
        if (typeof DTX !== 'undefined') DTX.onTelemetry(data);

        // ── NB2 Breaker: Parse real AC power data if present ────────────
        // Support both nested {"nb2": {...}} and flat {"voltage": ...} payloads from ESP
        let nb2Raw = data.nb2;
        if (!nb2Raw && data.voltage !== undefined) {
            nb2Raw = data;
        }
        const hasNb2 = nb2Raw && (nb2Raw.rs485_ok === true || nb2Raw.rs485_ok == 1 || nb2Raw.voltage !== undefined);

        let displayVoltage, displayCurrent, displayPower, displayPF;

        if (hasNb2) {
            // *** REAL DATA from NB2 CHINT breaker — replaces synthesized values ***
            const nb2V = parseFloat(nb2Raw.voltage) || 0;
            const nb2I = parseFloat(nb2Raw.current) || 0;
            const nb2P = parseFloat(nb2Raw.active_power) || 0;
            const nb2PF = parseFloat(nb2Raw.power_factor) || 0;
            const nb2Freq = parseFloat(nb2Raw.frequency) || 0;
            const nb2Energy = parseInt(nb2Raw.energy_wh) || 0;
            const nb2Apparent = parseFloat(nb2Raw.apparent_power) || 0;
            const nb2Reactive = parseFloat(nb2Raw.reactive_power) || 0;
            const nb2BreakerOn = !!nb2Raw.breaker_on;
            const nb2InternalTemp = parseFloat(nb2Raw.internal_temp) || 0;
            const nb2ResidualMa = parseFloat(nb2Raw.residual_current_ma) || 0;
            const nb2FaultFlags = parseInt(nb2Raw.fault_flags) || 0;
            const nb2AlarmFlags = parseInt(nb2Raw.alarm_flags) || 0;

            // Use REAL breaker readings for the main telemetry display
            displayVoltage = nb2V;
            displayCurrent = nb2I;
            displayPower = nb2P / 1000.0;   // W → kW for main display
            displayPF = nb2PF;

            SIM.current = nb2I;
            SIM.voltage = nb2V;

            // Update MQTT replica state
            MQTT_STATE.nb2.voltage = nb2V;
            MQTT_STATE.nb2.current = nb2I;
            MQTT_STATE.nb2.activePower = nb2P;
            MQTT_STATE.nb2.reactivePower = nb2Reactive;
            MQTT_STATE.nb2.apparentPower = nb2Apparent;
            MQTT_STATE.nb2.powerFactor = nb2PF;
            MQTT_STATE.nb2.frequency = nb2Freq;
            MQTT_STATE.nb2.energyWh = nb2Energy;
            MQTT_STATE.nb2.residualCurrentMa = nb2ResidualMa;
            MQTT_STATE.nb2.internalTemp = nb2InternalTemp;
            MQTT_STATE.nb2.breakerOn = nb2BreakerOn;
            MQTT_STATE.nb2.faultFlags = nb2FaultFlags;
            MQTT_STATE.nb2.alarmFlags = nb2AlarmFlags;
            MQTT_STATE.nb2.rs485Ok = true;

            // NB2 Power Monitor panel buffer
            TEL.nb2Voltage = nb2V.toFixed(1);
            TEL.nb2Current = nb2I.toFixed(3);
            TEL.nb2Power = nb2P.toFixed(1);
            TEL.nb2PF = nb2PF.toFixed(2);
            TEL.nb2Frequency = nb2Freq.toFixed(2);
            TEL.nb2Energy = nb2Energy.toString();
            TEL.nb2Apparent = nb2Apparent.toFixed(1);
            TEL.nb2Reactive = nb2Reactive.toFixed(1);
            TEL.nb2Temp = nb2InternalTemp.toFixed(1);
            TEL.nb2Residual = nb2ResidualMa.toFixed(1);
            TEL.nb2BreakerOn = nb2BreakerOn;
            TEL.nb2FaultFlags = nb2FaultFlags;
            TEL.nb2AlarmFlags = nb2AlarmFlags;
            TEL.nb2Rs485Ok = true;

            // Mark breaker sensor connected
            if (UI.statusBreaker) {
                UI.statusBreaker.textContent = 'CONNECTED';
                UI.statusBreaker.className = 'inspect-status-pill status-healthy';
            }
            if (UI.statusRs485) {
                const rsOk = (nb2Raw.rs485_ok === true || nb2Raw.rs485_ok == 1);
                UI.statusRs485.textContent = rsOk ? 'CONNECTED' : 'FAIL';
                UI.statusRs485.className = rsOk ? 'inspect-status-pill status-healthy' : 'inspect-status-pill status-critical';
            }

            // Decode and display physical breaker faults/alarms
            if (nb2FaultFlags > 0 || nb2AlarmFlags > 0) {
                let faultMsgs = [];
                if (nb2FaultFlags & 0x0001) faultMsgs.push("Short Circuit");
                if (nb2FaultFlags & 0x0002) faultMsgs.push("Overload");
                if (nb2FaultFlags & 0x0004) faultMsgs.push("Overvoltage");
                if (nb2FaultFlags & 0x0008) faultMsgs.push("Undervoltage");
                if (nb2FaultFlags & 0x0010) faultMsgs.push("Leakage (Residual)");
                if (nb2FaultFlags & 0x0020) faultMsgs.push("Over Temperature");
                if (nb2FaultFlags & 0x0040) faultMsgs.push("Phase Loss");
                if (nb2FaultFlags & 0x0080) faultMsgs.push("Voltage Unbalance");
                if (nb2FaultFlags & 0x0100) faultMsgs.push("OverPower");
                if (nb2FaultFlags & 0x0200) faultMsgs.push("UnderPower");
                if (nb2FaultFlags & 0x0400) faultMsgs.push("Phase Sequence");
                if (nb2FaultFlags & 0x0800) faultMsgs.push("Arc Fault");
                if (nb2FaultFlags & 0xF000) faultMsgs.push("Other Fault (0x" + (nb2FaultFlags & 0xF000).toString(16) + ")");

                if (nb2AlarmFlags & 0x0001) faultMsgs.push("Leakage ALARM");
                if (nb2AlarmFlags & 0x0002) faultMsgs.push("OverTemp ALARM");
                if (nb2AlarmFlags & 0x0004) faultMsgs.push("Unbalance ALARM");
                if (nb2AlarmFlags & 0x0008) faultMsgs.push("Overvoltage ALARM");
                if (nb2AlarmFlags & 0x0010) faultMsgs.push("Undervoltage ALARM");
                if (nb2AlarmFlags & 0x0020) faultMsgs.push("Overload ALARM");
                if (nb2AlarmFlags & 0xFFC0) faultMsgs.push("Other Alarm (0x" + (nb2AlarmFlags & 0xFFC0).toString(16) + ")");

                let fullText = faultMsgs.join(" | ");

                const faultBar = document.getElementById('nb2-fault-bar');
                const faultText = document.getElementById('nb2-fault-text');
                if (faultBar && faultText) {
                    faultBar.classList.remove('hidden');
                    faultBar.style.backgroundColor = 'rgba(255, 60, 60, 0.2)';
                    faultBar.style.border = '1px solid rgba(255, 60, 60, 0.5)';
                    faultBar.style.color = '#ff4d4d';
                    faultText.textContent = `BREAKER FAULT: ${fullText}`;
                }

                // Log it to the terminal once in a while to avoid spamming, or just log if changed
                if (nb2FaultFlags !== window.lastNb2FaultLogged) {
                    addLog(`[NB2] ⚠️ ELECTRICAL FAULT DETECTED: ${fullText}`, 'error');
                    window.lastNb2FaultLogged = nb2FaultFlags;
                }
            } else {
                const faultBar = document.getElementById('nb2-fault-bar');
                if (faultBar) {
                    faultBar.classList.add('hidden');
                }
                window.lastNb2FaultLogged = 0;
            }
        } else {
            // ── Fallback: synthesized electrical estimates from PWM% ──────
            let baseCurrent = 0.0;
            let calculatedVoltage = MOTOR.ratedVoltage;
            let pf = 0.85;

            if (SIM.isRunning) {
                const fraction = pwm / 100;
                baseCurrent = 0.5 + fraction * 3.5;
                if (SIM.faults.motorOverheat) baseCurrent *= 2.6;
                if (SIM.faults.beltOverload) baseCurrent *= 1.7;
                SIM.current = baseCurrent + (Math.random() - 0.5) * 0.15;
                if (SIM.current < 0) SIM.current = 0;
                calculatedVoltage = MOTOR.ratedVoltage - SIM.current * 0.3 + (Math.random() - 0.5) * 0.05;
                if (calculatedVoltage < 0) calculatedVoltage = 0;
                pf = SIM.faults.beltOverload ? 0.62 : 0.85 + (Math.random() - 0.5) * 0.02;
            } else {
                SIM.current = 0.0;
            }
            SIM.voltage = calculatedVoltage;
            displayVoltage = calculatedVoltage;
            displayCurrent = SIM.current;
            displayPower = (calculatedVoltage * SIM.current * pf) / 1000.0;
            displayPF = pf;

            // NB2 not available — mark disconnected
            TEL.nb2Rs485Ok = false;
            MQTT_STATE.nb2.rs485Ok = false;
            if (UI.statusBreaker) {
                UI.statusBreaker.textContent = 'NO RS485';
                UI.statusBreaker.className = 'inspect-status-pill status-warning';
            }
            if (UI.statusRs485) {
                UI.statusRs485.textContent = 'DISCONNECTED';
                UI.statusRs485.className = 'inspect-status-pill status-critical';
            }
        }

        const power = displayPower;

        // Telemetry double-buffer write
        TEL.rpm = rpm.toFixed(1);
        TEL.amp = displayCurrent.toFixed(2);
        TEL.volt = displayVoltage.toFixed(1);
        TEL.power = power.toFixed(3);
        TEL.pf = displayPF.toFixed(2);

        // Update non-engineering KPIs
        updateBusinessKPIs(power);

        // Real telemetry received — mark motor as connected
        if (UI.statusMotor) {
            UI.statusMotor.textContent = 'CONNECTED';
            UI.statusMotor.className = 'inspect-status-pill status-healthy';
        }

        // Proximity sensor → piece counter (rising-edge detection)
        if (prox && !HW.lastProxState) {
            SIM.pieceCount++;
            MQTT_STATE.pieceCount = SIM.pieceCount; // rising-edge, replica counter
            TEL.count = SIM.pieceCount.toString();
            addLog(`Proximity: part detected — total: ${SIM.pieceCount}`, 'info');
        }
        HW.lastProxState = prox;
        MQTT_STATE.proxDetected = prox;
        TEL.proximity = prox ? 'Detected' : 'Idle';

        // Proximity sensor receives data via the same telemetry packet — mark connected
        if (UI.statusProximity) {
            UI.statusProximity.textContent = 'CONNECTED';
            UI.statusProximity.className = 'inspect-status-pill status-healthy';
        }

        // Temp sensor: only mark CONNECTED if DS18B20 returned a valid reading
        // temp_c === null means the sensor is physically disconnected on the ESP32
        if (temp !== null) {
            TEL.tempVal = temp.toFixed(1);
            if (UI.statusTemp) {
                UI.statusTemp.textContent = 'CONNECTED';
                UI.statusTemp.className = 'inspect-status-pill status-healthy';
            }
        } else {
            TEL.tempVal = '--';
            if (UI.statusTemp) {
                UI.statusTemp.textContent = 'DISCONNECTED';
                UI.statusTemp.className = 'inspect-status-pill status-critical';
            }
        }

        // AI predictive — still estimated, now driven by real RPM
        let rul = '142.5 d';
        let anomaly = 0.8 + (Math.random() - 0.5) * 0.3;
        let efficiency = 94.2 - (rpm / SIM.maxRpm) * 2.0 + (Math.random() - 0.5) * 0.2;
        let nextService = 'Nominal';
        let serviceColor = 'var(--text-label)';
        let anomalyColor = 'var(--text-secondary)';

        if (SIM.faults.motorOverheat) {
            rul = `${(1.5 + Math.random() * 1.5).toFixed(1)} h`;
            anomaly = 98.4 + Math.random() * 1.2;
            efficiency = 41.5 + (Math.random() - 0.5) * 1.5;
            nextService = 'Immediate Abort'; serviceColor = 'var(--status-crit)'; anomalyColor = 'var(--status-crit)';
        } else if (SIM.faults.beltOverload) {
            rul = `${(7.8 + Math.random() * 1.2).toFixed(1)} d`;
            anomaly = 84.7 + Math.random() * 2.1;
            efficiency = 58.1 + (Math.random() - 0.5) * 1.0;
            nextService = 'Adjust Tension'; serviceColor = 'var(--status-warn)'; anomalyColor = 'var(--status-warn)';
        } else if (SIM.faults.looseScrew) {
            rul = `${(13.5 + Math.random() * 1.5).toFixed(1)} d`;
            anomaly = 34.2 + Math.random() * 1.8;
            efficiency = 88.7 + (Math.random() - 0.5) * 0.5;
            nextService = 'Tighten Fastener'; serviceColor = 'var(--status-warn)'; anomalyColor = 'var(--status-warn)';
        }

        TEL.rul = rul; TEL.anomaly = `${anomaly.toFixed(1)}%`; TEL.anomalyColor = anomalyColor;
        TEL.efficiency = `${efficiency.toFixed(1)}%`; TEL.service = nextService; TEL.serviceColor = serviceColor;
        TEL.dirty = true;

        if (SIM.selectedMesh) updateInspector(SIM.selectedMesh);
    } catch (e) {
        addLog(`[Error] Failed to parse JSON Telemetry: ${e.message}`, 'error');
    }
}

// ── Publish JSON command to ESP32 via MQTT ─────────────────────────────────────
function sendCmdObject(cmdObj) {
    if (!HW.connected || !HW.client) {
        addLog('Cannot send command: Hardware is not connected.', 'warning');
        return;
    }
    const payload = JSON.stringify(cmdObj);
    // Register the command so telemetry can later confirm it actually took effect.
    if (typeof DTX !== 'undefined') DTX.track(cmdObj);
    // QoS 1: the broker acknowledges receipt, so "sent" means the broker owns it
    // rather than "handed to a socket and hoped". At QoS 0 a dropped command was
    // indistinguishable from a delivered one — and a dropped heartbeat lets the
    // firmware's remote-command deadman force-stop the motor.
    HW.client.publish(MQTT_CFG.topicCmd, payload, { qos: 1 }, (err) => {
        if (err) {
            addLog(`[MQTT Command FAILED] ${payload} — ${err.message}`, 'error');
        } else {
            // Only logged after PUBACK. This is delivery to the broker, NOT proof the
            // device received, accepted or executed it — those need a device ack.
            addLog(`[MQTT Command Sent] → ${payload}`, 'success');
        }
    });
}

// ── Connect to Mosquitto broker ────────────────────────────────────────────────
function connectMQTT() {
    if (typeof mqtt === 'undefined') {
        addLog('MQTT.js not loaded — check your internet connection.', 'error');
        return;
    }
    if (HW.client) { disconnectMQTT(); return; }

    const profile = MQTT_CFG.activeProfile;
    addLog(`Connecting to MQTT broker [${profile.label}]: ${profile.brokerUrl} …`, 'info');

    // Auto-reconnect is ON. It was previously disabled (reconnectPeriod: 0), which
    // meant any transport interruption — a Wi-Fi blip, the laptop sleeping, the broker
    // closing an idle session, the browser throttling a background tab — left the page
    // dead until someone reloaded it. Backoff is applied in on('reconnect') below.
    const client = mqtt.connect(profile.brokerUrl, {
        clientId: MQTT_CFG.clientId,
        keepalive: 20,
        reconnectPeriod: 2000,
        connectTimeout: 8000,
        clean: true,
        resubscribe: true,
        ...profile.options,
    });
    HW.reconnectAttempt = 0;

    HW.client = client;

    client.on('connect', () => {
        HW.connected = true;
        HW.lastProxState = false;
        // Reset speed immediately so the 3D twin is stopped until real telemetry tells it to move
        SIM.rpm = 0;
        SIM.targetRpm = 0;
        SIM.isRunning = false;
        TEL.rpm = '0.0';
        TEL.amp = '0.00';
        TEL.speed = '0.00';
        TEL.power = '0.000';
        TEL.proximity = '--';
        TEL.tempVal = '--';
        // Reset NB2 fields
        TEL.nb2Voltage = '--'; TEL.nb2Current = '--'; TEL.nb2Power = '--';
        TEL.nb2PF = '--'; TEL.nb2Frequency = '--'; TEL.nb2Energy = '--';
        TEL.nb2Apparent = '--'; TEL.nb2Reactive = '--'; TEL.nb2Temp = '--';
        TEL.nb2Residual = '--'; TEL.nb2Rs485Ok = false; TEL.nb2BreakerOn = false;
        TEL.nb2FaultFlags = 0; TEL.nb2AlarmFlags = 0;
        TEL.dirty = true;

        // Reset MQTT replica — model stays frozen until first real packet arrives
        MQTT_STATE.rpm = 0;
        MQTT_STATE.isRunning = false;
        MQTT_STATE.proxDetected = false;
        MQTT_STATE.speedPercent = 0;
        MQTT_STATE.beltSpeed = 0;
        MQTT_STATE.lastPacketTime = 0;
        MQTT_STATE.isStale = false;

        client.subscribe('digital_twin/#', { qos: 0 });
        // Suspend synthetic background interval while hardware is active
        if (SIM.interval) { clearInterval(SIM.interval); SIM.interval = null; }
        updateHwBadge(true);
        updateSimControlsState();
        if (UI.statusPill) UI.statusPill.classList.add('active');
        if (UI.status) UI.status.textContent = 'Hardware Mode';
        addLog('Hardware mode active — receiving live ESP32 telemetry JSON via MQTT.', 'success');
        if (typeof DTX !== 'undefined') {
            DTX.tried.clear(); DTX.armFailover(); DTX.updateControlsEnabled();
            DTX.record('event', { event: 'connected', broker: BROKER.active });
        }
    });

    client.on('message', (topic, payload) => {
        if (topic === MQTT_CFG.topicSub || topic === 'digital_twin/motor/telemetry') {
            parseTelemetry(payload.toString());
        } else if (topic === 'digital_twin/motor/event') {
            try {
                const ev = JSON.parse(payload.toString());
                if (ev.kind === 'breaker_off_rejected') {
                    addLog('[NB2] ⛔ Breaker OFF REJECTED by bridge — wrong or missing passphrase.', 'error');
                }
            } catch (e) { /* ignore malformed event */ }
        }
    });

    // Log errors, but NEVER destroy the client here — doing so was what killed
    // auto-recovery. The client's own state machine owns reconnection.
    client.on('error', (err) => {
        addLog(`MQTT error: ${err.message}`, 'error');
    });

    // Exponential backoff with jitter, so a broker restart doesn't produce a
    // thundering herd of reconnects from every open dashboard.
    client.on('reconnect', () => {
        HW.reconnectAttempt = (HW.reconnectAttempt || 0) + 1;
        if (typeof DTX !== 'undefined') { DTX.health.reconnects++; DTX.record('event', { event: 'reconnect', attempt: HW.reconnectAttempt }); }
        const base = Math.min(30000, 2000 * Math.pow(2, HW.reconnectAttempt - 1));
        const delay = Math.round(base * (0.8 + Math.random() * 0.4));
        client.options.reconnectPeriod = delay;
        if (UI.status) UI.status.textContent = 'Reconnecting…';
        addLog(`MQTT reconnecting — attempt ${HW.reconnectAttempt}, next try in ${(delay / 1000).toFixed(1)} s.`, 'warning');
    });

    client.on('close', () => {
        if (HW.connected) {
            HW.connected = false;
            HW.running = false;
            HW.intentRunning = false;  // stop feeding the firmware deadman
            updateHwBadge(false);
            if (UI.status) UI.status.textContent = 'Reconnecting…';
            if (UI.statusPill) UI.statusPill.classList.remove('active');
            addLog('MQTT connection lost — reconnecting automatically, no refresh needed.', 'warning');
        }
        applyFreshnessToUI();
    });

    client.on('offline', () => {
        HW.connected = false;
        updateHwBadge(false);
        applyFreshnessToUI();
        // Repeated reconnect attempts that never land mean this broker is unusable.
        if ((HW.reconnectAttempt || 0) >= 3) BROKER.failover('unreachable');
    });
}

// Browsers throttle timers in hidden tabs (often to once a minute), so a tab left
// in the background can sit inside a stale backoff long after the network is back.
// Force a check the moment it is looked at again, and the moment the OS says online.
document.addEventListener('visibilitychange', () => {
    if (!document.hidden && HW.client && !HW.client.connected) HW.client.reconnect();
});
window.addEventListener('online', () => {
    if (HW.client && !HW.client.connected) HW.client.reconnect();
});

// Freshness is re-evaluated independently of packet arrival — that is the whole
// point, since the failure being detected is packets NOT arriving.
setInterval(applyFreshnessToUI, 500);

// ── Cleanly disconnect ─────────────────────────────────────────────────────────
function disconnectMQTT() {
    if (HW.client) { HW.client.end(true); HW.client = null; }
    HW.connected = false;
    HW.running = false;
            HW.intentRunning = false;  // stop feeding the firmware deadman
    HW.lastProxState = false;
    SIM.rpm = 0;
    SIM.targetRpm = 0;
    // Clear sensor readings — these are only valid from real hardware
    TEL.proximity = '--';
    TEL.tempVal = '--';
    // Reset NB2 fields
    TEL.nb2Voltage = '--'; TEL.nb2Current = '--'; TEL.nb2Power = '--';
    TEL.nb2PF = '--'; TEL.nb2Frequency = '--'; TEL.nb2Energy = '--';
    TEL.nb2Apparent = '--'; TEL.nb2Reactive = '--'; TEL.nb2Temp = '--';
    TEL.nb2Residual = '--'; TEL.nb2Rs485Ok = false; TEL.nb2BreakerOn = false;
    TEL.nb2FaultFlags = 0; TEL.nb2AlarmFlags = 0;
    TEL.dirty = true;
    // Freeze replica — no MQTT, no motion
    MQTT_STATE.rpm = 0;
    MQTT_STATE.isRunning = false;
    MQTT_STATE.proxDetected = false;
    MQTT_STATE.beltSpeed = 0;
    MQTT_STATE.lastPacketTime = 0;
    MQTT_STATE.isStale = false;
    updateHwBadge(false);
    updateSimControlsState();
    if (UI.statusPill) UI.statusPill.classList.remove('active');
    if (UI.status) UI.status.textContent = 'Standby';
    addLog('Hardware disconnected - simulation mode active.', 'info');
}

// ── Connect button ─────────────────────────────────────────────────────────────
if (UI.btnMqttConnect) {
    UI.btnMqttConnect.addEventListener('click', () => {
        HW.connected ? disconnectMQTT() : connectMQTT();
    });
}
const btnMqttModel = document.getElementById('btn-mqtt-connect-model');
if (btnMqttModel) {
    btnMqttModel.addEventListener('click', () => {
        HW.connected ? disconnectMQTT() : connectMQTT();
    });
}

// ── NB2 Breaker Control ───────────────────────────────────────────────────────
// SINGLE choke point for opening the breaker. Every path (panel OFF button,
// HARD POWER CUT) goes through breakerOff(), which is the only place that
// publishes {breaker:'off'} — and the only place the passphrase gate lives.
// The passphrase is typed by the operator, never stored in this file; the
// bridge verifies it against ~/DT_LINE/.dt_secret before forwarding to the ESP32.
function breakerOn() {
    if (!HW.connected) { addLog('[NB2] Not connected — breaker ON NOT sent.', 'warning'); return; }
    sendCmdObject({ breaker: 'on' });
    addLog('[NB2] Remote CLOSE (breaker ON) command sent.', 'info');
}

async function breakerOff({ estopFirst = true, label = 'panel' } = {}) {
    if (!HW.connected) { addLog('[NB2] Not connected — breaker OFF NOT sent.', 'warning'); return; }
    if (!confirm('⚠️ BREAKER OFF\n\nThe motor will be E-STOPPED, then the breaker opens — cutting AC power to the ENTIRE station. Motor, sensors and all field equipment de-energise immediately.\n\nProceed only if it is safe to do so.')) return;
    const key = window.prompt('Enter the breaker passphrase to confirm power cut:');
    if (!key) { addLog('[NB2] Breaker OFF cancelled — no passphrase.', 'info'); return; }
    if (estopFirst) {
        HW.intentRunning = false;   // drop the deadman feed first
        // Repeat the stop three times. It is idempotent, and losing it is far
        // worse than sending it twice.
        sendCmdObject({ cmd: 'estop' });
        setTimeout(() => { if (HW.connected) HW.client.publish(MQTT_CFG.topicCmd, JSON.stringify({ cmd: 'estop' }), { qos: 1 }); }, 250);
        setTimeout(() => { if (HW.connected) HW.client.publish(MQTT_CFG.topicCmd, JSON.stringify({ cmd: 'estop' }), { qos: 1 }); }, 600);
        await new Promise(r => setTimeout(r, 200));
    }
    sendCmdObject({ breaker: 'off', key });
    addLog(`[NB2] ⚠️ Breaker OFF sent (${label}) — awaiting bridge authorization.`, 'warning');
}

const btnNb2UnlockModel = document.getElementById('btn-nb2-unlock-model');
if (btnNb2UnlockModel) {
    btnNb2UnlockModel.addEventListener('click', () => {
        sendCmdObject({ nb2_unlock: true });
        addLog('[NB2] Remote unlock command sent.', 'info');
    });
}

if (UI.btnNb2On) UI.btnNb2On.addEventListener('click', breakerOn);
const btnNb2OnModel = document.getElementById('btn-nb2-on-model');
if (btnNb2OnModel) btnNb2OnModel.addEventListener('click', breakerOn);

if (UI.btnNb2Off) UI.btnNb2Off.addEventListener('click', () => breakerOff({ label: 'panel' }));
const btnNb2OffModel = document.getElementById('btn-nb2-off-model');
if (btnNb2OffModel) btnNb2OffModel.addEventListener('click', () => breakerOff({ label: 'panel' }));



// ============================================================================
// BABYLON.JS ENGINE SETUP
// ============================================================================
const canvas = document.getElementById('canvas3d');
const engine = new BABYLON.Engine(canvas, true, {
    preserveDrawingBuffer: true,
    stencil: true,
    antialias: true,
});

const createScene = async function () {
    const scene = new BABYLON.Scene(engine);

    // Canvas clear color matches --bg-base (#F1F5F9 = Slate-100)
    scene.clearColor = new BABYLON.Color4(0.945, 0.961, 0.976, 1.0);

    const camera = new BABYLON.ArcRotateCamera('Camera', -Math.PI / 2, Math.PI / 3, 2.2, BABYLON.Vector3.Zero(), scene);
    camera.attachControl(canvas, true);
    camera.wheelPrecision = 10;
    camera.minZ = 0.1;
    camera.lowerRadiusLimit = 0.5;
    camera.upperRadiusLimit = 3;

    // Prevent browser scroll on canvas wheel
    canvas.addEventListener('wheel', (e) => e.preventDefault(), { passive: false });

    const envTexture = BABYLON.CubeTexture.CreateFromPrefilteredData(
        'https://playground.babylonjs.com/textures/environment.dds', scene
    );
    scene.environmentTexture = envTexture;

    // -------------------------------------------------------------------------
    // POST-PROCESS PIPELINE — FXAA + Bloom + Vignette for spatial depth
    // Vignette darkens edges → pulls operator focus to the 3D model center.
    // -------------------------------------------------------------------------
    const pipeline = new BABYLON.DefaultRenderingPipeline('defaultPipeline', true, scene, [camera]);
    pipeline.samples = 4;
    pipeline.fxaaEnabled = true;
    pipeline.bloomEnabled = true;
    pipeline.bloomThreshold = 0.8;
    pipeline.bloomWeight = 0.35; // Reduced from 0.5 — subtler bloom

    // Vignette — mimics industrial WebGL viewers (Forge, three.js product viewers)
    pipeline.imageProcessingEnabled = true;
    pipeline.imageProcessing.vignetteEnabled = true;
    pipeline.imageProcessing.vignetteWeight = 2.0;
    pipeline.imageProcessing.vignetteColor = new BABYLON.Color4(0, 0, 0, 1);
    pipeline.imageProcessing.vignetteBlendMode = BABYLON.ImageProcessingConfiguration.VIGNETTEMODE_MULTIPLY;
    // Slight contrast lift to make the model pop against the flat bg
    pipeline.imageProcessing.contrast = 1.08;
    pipeline.imageProcessing.exposure = 1.0;

    // SSAO 2 Rendering Pipeline for ambient occlusion (crevice and corner contact shadows)
    const ssao = new BABYLON.SSAO2RenderingPipeline("ssaoPipeline", scene, { ssaoRatio: 0.5, blurRatio: 0.5 }, [camera]);
    ssao.radius = 0.08;
    ssao.totalStrength = 1.3;
    ssao.expensiveBlur = true;

    // Soft hemispheric fill light to prevent pitch-black unlit areas
    const hemiLight = new BABYLON.HemisphericLight('hemiLight', new BABYLON.Vector3(0, 1, 0), scene);
    hemiLight.intensity = 0.35;
    hemiLight.groundColor = new BABYLON.Color3(0.08, 0.11, 0.18); // Slate ground bounce

    // High-contrast directional light positioned to generate shadows
    const dirLight = new BABYLON.DirectionalLight('dirLight', new BABYLON.Vector3(-0.6, -1.2, -0.6), scene);
    dirLight.position = new BABYLON.Vector3(1.5, 3.0, 1.5);
    dirLight.intensity = 1.25;

    // Shadow Generator for realistic grounding shadows
    const shadowGenerator = new BABYLON.ShadowGenerator(1024, dirLight);
    shadowGenerator.useBlurExponentialShadowMap = true;
    shadowGenerator.blurKernel = 16;
    shadowGenerator.setDarkness(0.35);

    let kinematics = { pulleys: [], belts: [], boxes: [], shadowGenerator: shadowGenerator };

    addLog('Loading GLB Asset via Babylon.js...');
    const result = await BABYLON.SceneLoader.ImportMeshAsync('', 'assets/', 'Conveyor_Twin_v1.glb', scene);

    // Stop all baked animations on load
    if (result.animationGroups) {
        result.animationGroups.forEach(group => group.stop());
    }

    const rootNode = result.meshes[0];
    rootNode.position = BABYLON.Vector3.Zero();
    camera.setTarget(rootNode);

    // Cardboard material for spawned boxes
    const boxMat = new BABYLON.PBRMaterial('boxMat', scene);
    boxMat.albedoColor = new BABYLON.Color3(0.7, 0.55, 0.35);
    boxMat.roughness = 0.9;
    boxMat.metallic = 0.1;
    kinematics.boxMat = boxMat;

    result.meshes.forEach(mesh => {
        // Hide default rectangular room floor to replace with a sleek limited circular pedestal
        if (mesh.name === 'Room_Floor') {
            mesh.isVisible = false;
            return;
        }

        if (mesh.name !== 'Main_Belt' && (mesh.name.toLowerCase().includes('belt') || mesh.name.toLowerCase().includes('baked'))) {
            mesh.isVisible = false;
            return;
        }

        if (mesh.name.includes('Room_')) {
            if (mesh.material) mesh.material.backFaceCulling = false;
        }

        // Enable shadows for realistic depth
        mesh.receiveShadows = true;
        if (mesh.name !== '__root__' && !mesh.name.includes('Room_') && !mesh.name.includes('Background') && mesh.name !== 'canvas3d') {
            mesh.castShadows = true;
            shadowGenerator.addShadowCaster(mesh);
        }

        if (mesh.name.includes('Roller') || mesh.name.includes('Pulley') || mesh.name.includes('Shaft')) {
            kinematics.pulleys.push(mesh);
            let mat = mesh.material;
            if (!mat || mat.getClassName() !== 'PBRMaterial') {
                mat = new BABYLON.PBRMaterial(mesh.name + '_mat', scene);
                mesh.material = mat;
            }
            mat.metallic = 0.8;
            mat.roughness = 0.4;
            const dynamicTexture = new BABYLON.DynamicTexture('rollerTex', 256, scene, true);
            const ctx = dynamicTexture.getContext();
            ctx.fillStyle = '#888888'; ctx.fillRect(0, 0, 256, 256);
            ctx.fillStyle = '#000000'; ctx.fillRect(0, 0, 256, 32);
            dynamicTexture.update();
            mat.albedoTexture = dynamicTexture;
        }

        if (mesh.name === 'Main_Belt') {
            mesh.alwaysSelectAsActiveMesh = true;
            const pbr = new BABYLON.PBRMaterial('pvcBelt', scene);
            pbr.albedoColor = new BABYLON.Color3(1, 1, 1);
            pbr.metallic = 0.0;
            pbr.roughness = 0.95; // Rough, matte
            pbr.environmentIntensity = 0.10;
            pbr.microSurface = 0.0;
            pbr.specularIntensity = 0.0;
            pbr.useRadianceOcclusion = false;
            pbr.useHorizonOcclusion = false;
            pbr.clearCoat.isEnabled = false;
            pbr.backFaceCulling = false;

            const TW = 512, TH = 512;
            const dynTex = new BABYLON.DynamicTexture('beltTex', { width: TW, height: TH }, scene, false);
            const ctx = dynTex.getContext();

            // ── TUNING FACTOR (0.0 to 2.0+) ─────────────────────────────────────
            // 0 = completely soft/smooth, 1 = normal rugged, 2 = very rough
            const textureIntensity = 0.2;

            // Base color
            ctx.fillStyle = '#3D7757';
            ctx.fillRect(0, 0, TW, TH);

            // Tonal variation (uneven lighter and darker patches)
            for (let i = 0; i < 30; i++) {
                const x = Math.random() * TW;
                const y = Math.random() * TH;
                const r = 40 + Math.random() * 120;
                const grad = ctx.createRadialGradient(x, y, 0, x, y, r);
                const isLight = Math.random() > 0.5;
                grad.addColorStop(0, isLight ? `rgba(255,255,255,${0.06 * textureIntensity})` : `rgba(0,0,0,${0.08 * textureIntensity})`);
                grad.addColorStop(1, 'rgba(0,0,0,0)');
                ctx.fillStyle = grad;
                ctx.fillRect(x - r, y - r, r * 2, r * 2);
            }

            // Subtle grid/halftone pattern in some areas
            ctx.fillStyle = `rgba(0, 0, 0, ${0.12 * textureIntensity})`;
            for (let x = TW * 0.15; x < TW * 0.85; x += 4) {
                for (let y = 0; y < TH; y += 4) {
                    if (Math.random() > 0.4) { // Only in some areas/randomly dropped out
                        ctx.fillRect(x, y, 1.5, 1.5);
                    }
                }
            }

            // Faint vertical and horizontal scratch-like fiber lines
            ctx.lineWidth = 1;
            for (let i = 0; i < 150; i++) {
                ctx.strokeStyle = Math.random() > 0.5 ? `rgba(255, 255, 255, ${0.05 * textureIntensity})` : `rgba(0, 0, 0, ${0.06 * textureIntensity})`;
                const x = Math.random() * TW;
                ctx.beginPath();
                ctx.moveTo(x, 0);
                ctx.lineTo(x, TH);
                ctx.stroke();

                if (Math.random() > 0.7) { // Fewer horizontal lines
                    const y = Math.random() * TH;
                    ctx.beginPath();
                    ctx.moveTo(0, y);
                    ctx.lineTo(TW, y);
                    ctx.stroke();
                }
            }

            // Small scattered white specks (like dust or tiny fibers)
            ctx.fillStyle = `rgba(255, 255, 255, ${0.7 * textureIntensity})`;
            for (let i = 0; i < 1000; i++) {
                const x = Math.random() * TW;
                const y = Math.random() * TH;
                const size = Math.random() * 1.5 + 0.5;
                ctx.fillRect(x, y, size, size);
            }

            dynTex.update();
            dynTex.wrapU = BABYLON.Texture.WRAP_ADDRESSMODE;
            dynTex.wrapV = BABYLON.Texture.WRAP_ADDRESSMODE;
            dynTex.anisotropicFilteringLevel = 8;

            pbr.albedoTexture = dynTex;
            pbr.albedoTexture.wAng = Math.PI / 2; // Restored: Rotate 90deg so it scrolls vertically
            mesh.material = pbr;
            kinematics.belts.push(pbr);
        }
    });

    // Create a sleek, limited square pedestal (floor) under the conveyor
    const pedestal = BABYLON.MeshBuilder.CreateBox('pedestal', {
        width: 1.1,
        depth: 1.1,
        height: 0.002
    }, scene);
    pedestal.position = new BABYLON.Vector3(0.0, 0.0005, 0.0); // Slightly above absolute zero to avoid z-fighting
    pedestal.receiveShadows = true;

    // Matte presentation material for the pedestal
    const pedestalMat = new BABYLON.PBRMaterial('pedestalMat', scene);
    pedestalMat.albedoColor = new BABYLON.Color3(0.278, 0.333, 0.412); // Medium industrial slate-gray (Slate-600) for contrast
    pedestalMat.roughness = 0.8;
    pedestalMat.metallic = 0.1;
    pedestalMat.backFaceCulling = false;
    pedestal.material = pedestalMat;

    // Scale down any other lights loaded from the GLB to prevent flat washing
    scene.lights.forEach(light => {
        if (light !== dirLight && light !== hemiLight) {
            light.intensity = 0.25;
        }
    });

    if (UI.loader) UI.loader.classList.add('hidden');
    addLog('Digital Twin asset loaded successfully.', 'success');
    return { scene, kinematics, animationGroups: result.animationGroups };
};

// ============================================================================
// COMPONENT METADATA DATABASE
// ============================================================================
function getComponentMetadata(meshName) {
    let name = meshName;
    let category = 'Conveyor Component';
    let specs = 'Standard Industrial Part';
    let status = 'OPERATIONAL';
    let healthClass = 'status-healthy';

    if (meshName.includes('Screw')) {
        category = 'Fastener';
        if (meshName.includes('M3') || meshName.includes('Motor')) {
            name = 'Motor Mount Screw (M3)';
            specs = 'Shaft: 3.0mm | Head: 5.5mm | Socket: Cross (+)';
        } else {
            let parentPart = 'Structure';
            if (meshName.includes('EndGuard')) parentPart = 'End Guard';
            else if (meshName.includes('Leg')) parentPart = 'Frame Leg';
            name = `${parentPart} Screw (M4)`;
            specs = 'Shaft: 4.0mm | Head: 7.0mm | Socket: Cross (+)';
        }
        if (SIM.faults.looseScrew && meshName.includes('Left_A_Leg_Rect_Screw_1.001')) {
            status = 'CRITICAL (LOOSE)';
            healthClass = 'status-critical';
        }
    } else if (meshName.includes('MTR_') || meshName.includes('Motor')) {
        category = 'Actuator / Motor';
        if (meshName.includes('Body')) name = 'Motor Main Body';
        else if (meshName.includes('Gearbox')) name = 'Motor Reduction Gearbox (10:1)';
        else if (meshName.includes('Encoder')) name = 'Motor Rotary Encoder';
        else if (meshName.includes('Shaft')) name = 'Motor Output Shaft';
        else name = 'Motor Component';

        // Temperature only shown when received from real MQTT hardware
        const currentTempStr = (HW.connected && TEL.tempVal !== '--') ? `${TEL.tempVal}°C` : '--';

        specs = `Type: Brushless DC | Voltage: 24V | Max RPM: 167 | Temp: ${currentTempStr}`;
        if (SIM.faults.motorOverheat || (HW.connected && TEL.tempVal !== '--' && parseFloat(TEL.tempVal) > 75)) {
            status = `CRITICAL (OVERHEAT: ${currentTempStr})`;
            healthClass = 'status-critical';
        } else {
            status = 'OPERATIONAL';
            healthClass = 'status-healthy';
        }
    } else if (meshName.includes('HW_Sensor') || meshName.toLowerCase().includes('proximity') || meshName.toLowerCase().includes('sensor')) {
        category = 'Sensor';
        name = 'E18-D80NK Proximity Sensor';
        const proxState = HW.connected ? TEL.proximity : (SIM.isRunning ? TEL.proximity : 'Idle');
        specs = `Type: Infrared | Range: 3-80cm | Output: NPN NO | State: ${proxState}`;
        status = proxState === 'Detected' ? 'ACTIVE (DETECTED)' : 'OPERATIONAL (IDLE)';
        healthClass = proxState === 'Detected' ? 'status-warning' : 'status-healthy';
    } else if (meshName.includes('Belt') || meshName.includes('Main_Belt')) {
        category = 'Transmission Belt';
        name = 'Main Conveyor PVC Belt';
        specs = 'Material: Anti-static Green PVC | Width: 100mm';
        if (SIM.faults.beltOverload) {
            status = 'WARNING (SLIPPAGE / OVERLOAD)';
            healthClass = 'status-warning';
        }
    } else if (meshName.includes('Roller')) {
        category = 'Rolling Component';
        name = meshName.includes('1') ? 'Drive Roller' : 'Driven Roller';
        specs = 'Diameter: 22mm | Width: 134mm | Bearings: Dual Shielded';
    } else if (meshName.includes('Pulley')) {
        category = 'Transmission Pulley';
        name = meshName.includes('1') ? 'Motor Drive Pulley' : 'Conveyor Driven Pulley';
        specs = 'Material: Aluminum | Pitch: GT2 | Teeth: 20';
    } else if (meshName.includes('BearingCap')) {
        category = 'Bearing Housing';
        name = meshName.includes('Left') ? 'Left Shaft Bearing Cap' : 'Right Shaft Bearing Cap';
        specs = 'Bearing Type: Ball Bearing 608RS | Material: Cast Iron';
    } else if (meshName.includes('EndGuard')) {
        category = 'Safety Guard';
        name = meshName.includes('Left') ? 'Left End Safety Shield' : 'Right End Safety Shield';
        specs = 'Material: Powder-coated Sheet Metal | Thickness: 2.0mm';
    } else if (meshName.includes('Leg')) {
        category = 'Support Structure';
        name = meshName.includes('A') ? 'Support A-Leg Frame' : 'Support B-Leg Frame';
        specs = 'Material: Extruded Aluminum | Profile: 40×40';
    } else if (meshName.includes('Support_Bed_Plate')) {
        category = 'Load Bed';
        name = 'Conveyor Slide Bed Plate';
        specs = 'Material: Brushed Stainless Steel | Friction Coeff: 0.15';
    }

    return { name, category, specs, status, healthClass };
}

function updateInspector(mesh) {
    // ── Tab 2 inspector panel ──
    if (!mesh) {
        if (UI.inspectorIdle) UI.inspectorIdle.classList.remove('hidden');
        if (UI.inspectorDetails) UI.inspectorDetails.classList.add('hidden');
    } else {
        const meta = getComponentMetadata(mesh.name);
        if (UI.inspectName) UI.inspectName.textContent = meta.name;
        if (UI.inspectCategory) UI.inspectCategory.textContent = meta.category;
        if (UI.inspectSpecs) UI.inspectSpecs.textContent = meta.specs;
        if (UI.inspectStatus) {
            UI.inspectStatus.textContent = meta.status;
            UI.inspectStatus.className = `inspect-status-pill ${meta.healthClass}`;
        }
        if (UI.inspectorIdle) UI.inspectorIdle.classList.add('hidden');
        if (UI.inspectorDetails) UI.inspectorDetails.classList.remove('hidden');
    }

    // [SIM-INSPECTOR] Tab 3 inspector panel — mirrors Tab 2 using separate DOM IDs.
    // The 3D canvas is shared, so pointer clicks fire for both tabs; we show the
    // correct panel based on which tab is currently active.
    // To remove: delete this block and the inspector HTML in Tab 3 (index.html).
    const simDetails = document.getElementById('inspector-details-sim');
    const simName = document.getElementById('inspect-name-sim');
    const simCategory = document.getElementById('inspect-category-sim');
    const simSpecs = document.getElementById('inspect-specs-sim');
    const simStatus = document.getElementById('inspect-status-sim');

    if (!mesh) {
        if (simDetails) simDetails.classList.add('hidden');
    } else {
        const meta = getComponentMetadata(mesh.name);
        if (simName) simName.textContent = meta.name;
        if (simCategory) simCategory.textContent = meta.category;
        if (simSpecs) simSpecs.textContent = meta.specs;
        if (simStatus) {
            simStatus.textContent = meta.status;
            simStatus.className = `inspect-status-pill ${meta.healthClass}`;
        }
        if (simDetails) simDetails.classList.remove('hidden');
    }
}

const btnCloseInspector = document.getElementById('btn-close-inspector');
if (btnCloseInspector) {
    btnCloseInspector.addEventListener('click', () => {
        if (typeof SIM !== 'undefined' && SIM.selectedMesh) {
            SIM.selectedMesh.renderOutline = false;
            SIM.selectedMesh = null;
        }
        updateInspector(null);
    });
}

// [SIM-INSPECTOR] Close button for the Tab 3 inspector panel.
// To remove: delete this block and the inspector HTML in Tab 3 (index.html).
const btnCloseInspectorSim = document.getElementById('btn-close-inspector-sim');
if (btnCloseInspectorSim) {
    btnCloseInspectorSim.addEventListener('click', () => {
        if (typeof SIM !== 'undefined' && SIM.selectedMesh) {
            SIM.selectedMesh.renderOutline = false;
            SIM.selectedMesh = null;
        }
        updateInspector(null);
    });
}


function animateCameraTarget(camera, newTarget, scene) {
    BABYLON.Animation.CreateAndStartAnimation(
        'animCamTarget', camera, 'target',
        60, 30,
        camera.target.clone(), newTarget,
        BABYLON.Animation.ANIMATIONLOOPMODE_CONSTANT
    );
}

// [TAB2-SPARKLINE] Voltage sparkline history — stores last 10 voltage samples.
const powerSparklineHistory = [];

function drawPowerSparkline(data) {
    const canvas = document.getElementById('model-sparkline-volt');
    if (!canvas || data.length < 2) return;
    const ctx = canvas.getContext('2d');
    const W = canvas.width;
    const H = canvas.height;
    ctx.clearRect(0, 0, W, H);
    const minV = Math.min(...data) - 0.5;
    const maxV = Math.max(...data) + 0.5;
    const range = maxV - minV || 1;
    ctx.beginPath();
    data.forEach((v, i) => {
        const x = (i / (data.length - 1)) * W;
        const y = H - ((v - minV) / range) * H;
        i === 0 ? ctx.moveTo(x, y) : ctx.lineTo(x, y);
    });
    ctx.strokeStyle = '#0284C7';
    ctx.lineWidth = 1.5;
    ctx.stroke();
    // Fill gradient
    ctx.lineTo(W, H); ctx.lineTo(0, H); ctx.closePath();
    const grad = ctx.createLinearGradient(0, 0, 0, H);
    grad.addColorStop(0, 'rgba(2,132,199,0.25)');
    grad.addColorStop(1, 'rgba(2,132,199,0)');
    ctx.fillStyle = grad;
    ctx.fill();
}
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
