JehadMajed/DT_LINE/(commit log)

2026-08-31 Add multi-cloud MQTT streaming: Cloudflare Tunnel, HiveMQ Cloud, EMQX Cloud
    Bridge now publishes telemetry to all enabled brokers simultaneously
    (cloud brokers throttled to 1 msg/5s), dashboard gets a broker-profile
    selector to pick which stream to view/control from.
    [app.js, serial_mqtt_bridge.py]
2026-08-31 Default broker profile to HiveMQ Cloud (stable hostname vs Cloudflare Quick Tunnel)
    [app.js]
2026-08-31 Point camera feed at Pi's go2rtc stream via Tailscale Funnel
    CSI camera now served publicly through a stable rpi5.tail05b01c.ts.net
    URL instead of the LAN-only mediamtx address.
2026-09-02 Add 24/7 deployment kit + fix MQTT command subscription loss
    Bridge: subscribe inside on_connect so the command subscription survives
    cloud-broker reconnects (telemetry is publish-only and was masking the
    break). Add serial auto-reconnect and a port lock so telemetry reads and
    command writes never collide on /dev/ttyUSB0.
    deploy/: systemd units for the bridge and go2rtc camera (Restart=always,
    enabled at boot), cron watchdog, installer, stability test, runbook.
    [serial_mqtt_bridge.py]
2026-09-02 Harden bridge: single-instance lock, clean shutdown, backoff; drop redundant camera unit
    The real cause of 'commands not applied' was a second service
    (dt-serial-bridge.service) running the same script and fighting for the
    serial port. install.sh now removes duplicate bridge units; the script
    takes a pid lock and exits if another copy is alive; SIGTERM shuts down
    cleanly so systemctl restart never orphans a process. Watchdog now
    enforces exactly one bridge process and checks go2rtc.service (the Pi's
    existing camera service) instead of a redundant dt-camera unit.
2026-09-02 Camera feed: switch dashboard player from MSE to WebRTC (lower latency, no rebuffering over Tailscale Funnel)
2026-09-02 Fix cursor vanishing + repair corrupted style.css
    - Remove 'Kiosk Mode' rule (html,body,* { cursor:none !important }) that
    hid the mouse cursor everywhere, most disruptively over the 3D canvas.
    - The file tail had been appended via PowerShell >> as UTF-16, leaving
    1154 NUL bytes mixed into the UTF-8 CSS. Re-saved as clean UTF-8 (LF).
2026-09-02 Camera: WebRTC->MSE fallback so remote (Tailscale Funnel) viewers still get the feed
    WebRTC needs UDP 8555 which the Funnel does not expose; only LAN/tailnet
    viewers can use it. mode=webrtc,mse lets go2rtc fall back to MSE for
    everyone coming through the Funnel.
2026-09-02 Watchdog + installer: also verify/restore the Tailscale Funnel mapping
    The oneshot funnel unit can fail silently at boot when tailscaled isn't
    online yet, dropping the public camera URL. Watchdog now re-applies the
    :1984 funnel if the mapping is gone.
2026-09-02 Fix service detection + stale dt-camera refs in test/install/watchdog
    Use 'systemctl cat' to detect units (list-unit-files grep was missing
    go2rtc/tailscale-funnel). test_stability.sh now checks the real camera
    units instead of the removed dt-camera.
2026-09-02 Camera iframe: drop mode param, use go2rtc auto-negotiation (matches working direct URL)
2026-09-02 Camera panel: drop object-fit:cover on the iframe (caused rightward shift/clip)
2026-09-02 Camera panel: scale-to-fit the go2rtc iframe
    go2rtc stream.html forces flex:1 0 320px on its <video-stream>, so on the
    ~294px dashboard panel it overflowed right — frame shifted, edge and the
    RTC label clipped. Render the iframe at a fixed 640px logical width and
    scale it to the viewport via a ResizeObserver.
    [app.js]
2026-09-02 Gate breaker OFF behind a passphrase, verified at the bridge
    - app.js: single breakerOff() choke point for both the panel OFF button and
    HARD POWER CUT; prompts for a passphrase (never stored client-side) and
    sends it as {breaker:'off',key:...}. breakerOn() centralised too.
    - serial_mqtt_bridge.py: verifies the key against ~/DT_LINE/.dt_secret
    (git-ignored) before forwarding; wrong/missing key is dropped and a
    breaker_off_rejected event is published.
    - dashboard shows the rejection in the activity log.
    - add .gitignore (.dt_secret, __pycache__).
    [app.js, serial_mqtt_bridge.py]
2026-09-04 Dashboard reliability: reconnect, command confirmation, recorder, camera recovery
    Frontend-only changes; no firmware or bridge modifications.
    Connection
    - Enable MQTT auto-reconnect (reconnectPeriod 0 -> 2000) with exponential
    backoff + jitter, resubscribe, and visibilitychange/online handlers. The
    client is no longer destroyed in on('error'), which previously killed any
    chance of recovery and forced a manual page refresh.
    - Broker auto-failover: 25 s of silence rolls to the next configured profile.
    Commands
    - Send mode+start as ONE atomic message instead of two publishes raced by an
    80 ms timer; if the mode message was lost the start was rejected while the UI
    still reported succ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
    [app.js]
2026-09-04 Bridge-side heartbeat relay: hold operator intent, feed the firmware deadman locally
    The firmware force-stops the motor and reverts to MANUAL if it sees no serial
    command for 3000 ms (measured on the flashed binary: 3002/3011/3011 ms over
    three runs, not taken from the repo constant). The dashboard heartbeat had to
    cross a cloud broker to satisfy that, so any broker hiccup >3 s stopped the belt
    and silently disarmed REMOTE -- the "starts briefly, stops, works on the second
    click" symptom.
    The dashboard heartbeat now expresses operator INTENT only, held here with a 6 s
    budget, while a relay thread feeds the firmware deadman locally over USB every
    1 s. The safety property holds by constructio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
    [serial_mqtt_bridge.py]
2026-09-04 Publish state changes immediately; collapse repeated console lines
    Item 0.5 -- console noise. The 1 Hz relay makes the ESP32 echo the same [CMD]
    line every second (~3600 lines/hour while running), which would bury real events
    and be ingested wholesale by the SQLite logger. Collapse repeats per line: print
    the first, then every 30th with a count. Counting is per-line rather than
    consecutive because the ESP32 interleaves [TEMP] with [CMD], which a
    consecutive-duplicate check would miss entirely.
    Item 1 -- throttle bypass on state change. Cloud plans are throttled to 1 msg/5s
    per topic to stay inside free tiers, and that throttle was the sole cause of the
    2.9-8.0s telemetry gaps (the firmware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
    [serial_mqtt_bridge.py]
2026-09-04 LWT + birth + retained state document, and timer-driven device liveness
    Addition A -- disarm on expiry/latch. The firmware deadman is gated on
    targetSpeedPercent > 0, so a device left in REMOTE with the motor stopped stays
    ARMED indefinitely, and a stray {cmd:start} on any of the three brokers would
    start the belt with no arming step. Intent expiry and the latch now send
    {"mode":"manual"} after the stop, returning the device to a disarmed state.
    Items 2+3 -- state publishing and liveness, implemented together.
    The existing digital_twin/motor/telemetry topic is deliberately left alone and
    NOT retained. Its payload carries only uptime_ms, no wall clock, and consumers
    measure freshness from a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
    [serial_mqtt_bridge.py]
2026-09-04 Cut the encoder topic from cloud, throttle state to 15s, add the SQLite logger
    RATE. Total cloud rate was ~1.4M messages/month per broker against a ~1M free
    tier. Items 2+3 exposed this rather than caused it: the baseline of encoder +
    telemetry was already ~929k.
    The encoder topic has no cloud consumer. app.js subscribes to digital_twin/#
    but its message handler dispatches only motor/telemetry and motor/event, and
    Scripts/NodeRED_DEV08_Optimized_v2.json contains no MQTT nodes and no
    digital_twin topics at all. That was ~497k messages/month published to brokers
    nobody reads, carrying data we do not currently trust. It is now local-only, at
    full 1 Hz, which is where encoder triage happens.
    l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
    [dt_store.py, serial_mqtt_bridge.py]
2026-09-04 Adopt the archive/ layout from main, and repoint the service at it
    main (50917ce) moved every non-web file under archive/ so the repo root is only
    the GitHub Pages deploy assets. This branch was cut from vision, which predates
    that move, so the bridge lived at the root and merging would have produced two
    copies of serial_mqtt_bridge.py -- a stale one under archive/ and the live one
    at the root -- with the running service depending on which path systemd pointed
    at. Replicating the same move here makes the merge a plain content merge.
    Moved to archive/ to match main exactly, plus dt_store.py and tools/ which
    belong beside the bridge. Repointed ExecStart and WorkingDirectory in
    deploy/dt-bridg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
2026-09-04 Command identity, cross-broker dedupe, full audit trail, and a forward ack
    Item 5. Plumbing and audit only -- it deliberately does NOT arbitrate. The
    dashboard fails over between brokers after 25 s of silence, so one operator
    legitimately changes broker mid-run; any "reject commands from another broker"
    rule would turn that failover into a command blackout. Real arbitration needs a
    client identity the deployed dashboard does not send yet.
    IDENTITY. Optional "id" and "src" are accepted when present and a uuid4 id is
    generated when absent, so legacy commands still get one. Both are stripped
    before the serial write: the firmware parses strictly and rejects payloads over
    240 chars, and there is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
    [dt_store.py, serial_mqtt_bridge.py]
2026-09-04 Automatic broker failover: HiveMQ primary, EMQX fallback, no manual selection
    Removes the manual broker dropdown. The dashboard now starts on the primary,
    fails over on its own, and returns to the primary when it recovers.
    - Drop the "cloudflare" profile. It pointed at a Cloudflare Quick Tunnel whose
    hostname changes on every restart, and the tunnel is not running. It was dead
    config. (Unrelated to the bridge's local-Mosquitto plan, which happens to share
    the name and is kept for on-Pi diagnostics.)
    - BROKER_ORDER defines preference; index 0 is the primary.
    - Failover triggers on telemetry silence past FAILOVER_SILENCE_MS, and on three
    failed reconnect attempts (broker unreachable).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
    [app.js]
2026-09-04 Remove 3 s display throttle from the replica HUD
    The RPM and belt-speed readouts repainted at most every 3 s
    (REPLICA_HUD_REFRESH_MS), which added up to 3 s of latency on top of an
    otherwise ~1 s pipeline — larger than every transport delay after it combined.
    The throttle existed because applyTolerance() re-randomised the value on every
    repaint, so painting per frame made the number flicker. Fixed by decoupling the
    two: the tolerance is now rolled ONCE per packet, at arrival in parseTelemetry,
    and stored as MQTT_STATE.displayRpm / displayBelt. The HUD renders those stored
    values every frame.
    Better on both counts: the readout updates the moment a packet lands, and the
    jitter now reads as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
    [app.js]
2026-09-04 Native WebRTC camera player so latency is finally measurable
    The feed was a cross-origin iframe, which is a black box: it hides
    RTCPeerConnection.getStats() entirely. Camera delay could only be inferred from
    frame-delivery rates, and that measures throughput, not latency — a
    video-duration-versus-wallclock check showed a constant ~0.37 % shortfall both
    before and after a bitrate change, which is the camera running at ~11.96 fps
    rather than 12.000, and says nothing about lag.
    Owning the peer connection gives, per viewer and with no site access:
    - jitter-buffer delay (jitterBufferDelay / jitterBufferEmittedCount), the
    dominant and previously invisible component of perceived delay
    - round-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
    [app.js]
2026-09-04 Camera: 640x360 @ 500 kbit/s with a STUN candidate, plus a transport poller
    CAMERA CONFIG (archive/deploy/go2rtc.yaml; the live file is ~/go2rtc.yaml).
    Resolution and bitrate: 960x540 @ 1000 kbit/s -> 640x360 @ 500 kbit/s, 12 fps,
    --intra 12 kept. This is a VIEWER-COUNT decision, not a latency one. go2rtc does
    not transcode, so every consumer takes its own full-rate copy: at 1.0 Mbit/s two
    viewers use ~70% of the ~3.2 Mbit/s uplink and four saturate it; at 0.5 Mbit/s
    roughly six fit. Measured delivery fell from 1.07 to 0.59 Mbit/s per viewer.
    --mode 1920:1080 is load-bearing and must not be dropped. Without it,
    rpicam-vid picks the imx219 640x480 sensor mode (it satisfies >=640x360), which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
2026-09-04 Escalating recovery (rungs 1 and 3), and repair the watchdog that never ran
    ITEM 6 -- escalating recovery, driven by the liveness timer.
    15 s device silence -> DTR/RTS soft reset on the port we already hold
    30 s -> rung 2 REACHED but DISABLED, logged with the manual command
    60 s -> alert, and STOP retrying; the ladder latches
    Rung 2 (the uhubctl VBUS cycle) is permanently disabled by owner instruction. It
    is the only automatic action that could leave the site unrecoverable: with no
    physical access, a port that fails to re-enumerate after a power cut is gone.
    The rung is kept in code and logs what it WOULD have done, so the escalation is
    visible in the in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
    [serial_mqtt_bridge.py]
2026-09-04 Never sustain a run we cannot observe; keep the watchdog off the camera
    BLIND-RUN GUARD. The recovery ladder triggers on TELEMETRY silence, which is
    device -> bridge, but the relay writes in the opposite direction. In a one-way
    serial failure -- RX broken, TX fine -- telemetry is dead so we are blind, yet
    the relay kept feeding the firmware deadman and the belt would have kept running
    unobserved until rung 1 fired at 15 s. The firmware's own 3 s deadman cannot
    save us there, because we are the ones feeding it.
    Confirmed in the code as it stood: relay_loop never consulted _device_online,
    the liveness offline branch never touched intent, and the latch in
    note_device_state only fires on teleme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
    [serial_mqtt_bridge.py]
2026-09-04 Give the WebRTC player its own STUN servers
    go2rtc advertises genuinely STUN-mapped srflx candidates (verified in a live SDP
    answer: 77.31.219.95:61516 and :64401, with real ephemeral rports), so the
    browser could in principle offer host candidates only and still pair.
    But the Pi is behind carrier-grade NAT on a 4G link, and relying on a single
    direction succeeding is fragile. Offering browser-side srflx candidates too lets
    ICE pair from either end. Costs one STUN round trip during setup.
    Context: the camera feed was falling back to the embedded player because go2rtc
    had no `api: origin` set, so the cross-origin signalling POST was blocked. That
    is now fixed on the Pi side, which makes thi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
    [app.js]
2026-09-04 Fix camera view clipped to its top-left corner on the WebRTC player
    The native video element was given class="cam-media", which is wrong for it.
    .cam-media is a rigid 640x360 box anchored at top-left, sized for the go2rtc page
    inside the iframe, which fitIframe() then scales down with a transform to fit the
    panel. That transform targets camFeedIframe only.
    So the video sat at a fixed 640x360 with no scaling, and the viewport's
    overflow:hidden clipped it to its top-left corner — hiding about 96 % of the
    frame at the panel's normal width. It read as if the camera had been physically
    moved or zoomed in, and it appeared to correct itself when the window was
    enlarged, because a wider panel sim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
2026-09-04 Camera: stop hidden iframe fallback player from staying a live second WebRTC consumer
    The dashboard loads the go2rtc bundled stream.html player unconditionally
    in an iframe, then also opens its own native RTCPeerConnection (CAM). On
    native success, only iframe.classList.add("hidden") ran - a CSS-only
    hide that does not pause the iframe's script execution or close its own
    WebRTC session. Confirmed via /api/streams: two simultaneous consumers
    (webrtc/json = native CAM, webrtc/ws+udp = the hidden iframe) pulling the
    full-rate pi_cam stream at the same time for a single viewer, doubling
    uplink demand over the site's 4G/CGNAT path.
    Fix: blank iframe.src on native success to actually close its se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
    [app.js]
2026-09-06 Camera: fix WebRTC signalling (was calling go2rtc's API against MediaMTX) and replace the same-transport iframe fallback with real HLS
    The native player never actually worked against the new MediaMTX/Cloudflare
    backend - it was still POSTing JSON to go2rtc's /api/webrtc endpoint, which
    doesn't exist on MediaMTX, so every session failed immediately and fell back
    to an iframe that also just loaded MediaMTX's own WebRTC page. Same
    transport, same failure modes, so a bad network broke both at once.
    - CAM.start() now speaks MediaMTX's actual WHEP protocol (raw SDP POST/response)
    - Fallback is now real HLS via hls.js, a genuinely different transport that
    survives carrier NAT rebinding and cellu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
    [app.js]
2026-09-06 Fix leftover unresolved merge conflict markers in index.html
    The merge of the camera fix into the Simulation-tab-updates branch left
    literal <<<<<<< / ======= / >>>>>>> markers committed in two spots: the
    camera feed player block (kept the WebRTC+HLS version, dropped the old
    go2rtc/Tailscale iframe) and the closing script tags (kept the hls.js
    addition, bumped sim_engine.js's cache-bust to v=4 since its content
    changed after v=3 was set).
2026-09-06 Reconstruct correct final version: Tab 2 operator console UI + camera fix + Tab 3 conveyor simulation
    The prior merge (ed170b0) auto-resolved index.html and style.css against a
    stale local copy predating a large amount of already-existing work,
    silently reverting it with no conflict markers to flag it:
    - Tab 2's redesigned operator console (semantic .btn system, sticky E-STOP
    dock, collapsible hardware-summary chip, tablet/touch responsive rules)
    was replaced by the older ad-hoc inline-styled buttons.
    - Tab 3 briefly came back as a physics-based Philips LED Panel simulation
    (Arrhenius thermal aging, 40-lamp grid) that predates the current
    conveyor-belt simulation and doesn't match t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
2026-09-06 Camera: detect a connected-but-unwatchable WebRTC path and fall back to HLS
    Found live: a remote viewer's direct (srflx) path was retransmitting so
    heavily it sent 336MB in ~5 minutes for an 800kbps stream, saturating the
    uplink and growing the jitter buffer past 4s - while RTCPeerConnection's
    connectionState stayed 'connected' the whole time. Nothing reacted because
    nothing was watching quality, only hard failure.
    - bufferMs was also a lifetime-cumulative average (jitterBufferDelay /
    jitterBufferEmittedCount, both cumulative), so it could only climb and
    stopped reflecting anything current after the first minute. Switched to
    a delta between polls - the mean buffer delay for just the l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
    [app.js]
2026-09-06 Camera: detect a fully-frozen WebRTC stream, not just a growing buffer
    The previous fix (4535ef3) only caught a buffer that keeps growing between
    polls. A full stall - zero new frames emitted at all - leaves bufferMs at
    null (there is no delta to compute one from), so it was invisible to that
    check. That is exactly the worst case: a frozen picture, not just a laggy
    one, and it went completely unhandled.
    pollStats() now tracks frame-count delta directly; three consecutive polls
    (~6s) with zero new frames triggers the same HLS fallback used for a
    growing buffer or a hard failure.
    [app.js]
2026-09-06 Camera: fix false-positive native-HLS detection causing an unrecoverable black screen
    canPlayType('application/vnd.apple.mpegurl') returned truthy on a non-Safari
    browser, so startHls() set video.src directly to the .m3u8 URL instead of
    using hls.js. That browser can't actually demux HLS from a plain <video src>
    - it failed immediately (DEMUXER_ERROR_COULD_NOT_PARSE) - and since nothing
    was watching that native path for success/failure, hlsActive stayed true
    forever with a black screen and no recovery. Confirmed live: this is what
    was actually happening under 'camera is fully delayed'.
    Fix: use hls.js whenever Hls.isSupported() says it can run here (the
    standard, reliable pattern) and treat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
    [app.js]
2026-09-06 Camera: retry a stalled HLS play() and watch playback progress, not just load success
    Confirmed live: after the previous fix got hls.js actually loading the
    stream correctly (proper blob: URL, readyState 4, no error), the video sat
    fully buffered but paused at currentTime 0 forever. play() at
    MANIFEST_PARSED time can fail or get interrupted before segments are
    buffered, and nothing was retrying it or verifying playback actually
    started - loading successfully and playing successfully are different
    things, and only the first was being checked.
    startHlsHealthCheck() now polls every 3s: retries play() if paused, and
    escalates to the same auto-restart path used for hard errors if
    currentTime gen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
    [app.js]
2026-09-06 Camera: stop racing back to WebRTC on every recovery - retry HLS instead
    Confirmed live via mediamtx's own session logs: two concurrent viewers
    sharing the uplink triggered 'write queue is full' on WebRTC, my recovery
    logic correctly detected it and closed the session - then scheduleAutoRestart
    always retried via native WebRTC again, immediately re-hitting the same
    bandwidth ceiling and failing again. That's the 'peer connection closed,
    retrying' loop: not broken, just retrying the wrong transport repeatedly
    against a condition that hadn't changed.
    scheduleAutoRestart() now retries HLS (the transport that's actually
    resilient to this) by default. Only the true dead-end case - no HLS support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
    [app.js]
2026-09-06 Camera: shorten the auto-restart cooldown from 5 minutes to 20 seconds
    Confirmed live during a 3-concurrent-viewer stress test: MediaMTX itself
    crashed on a broken source pipe (uncaught libav exception) and recovered
    via Restart=always in ~12 seconds - but two of the three viewers, caught
    mid-degradation when that happened, sat completely dead for 5 minutes over
    a server-side problem that was gone in 12 seconds.
    Retries now default to HLS (cheap for the server, not a fresh WebRTC
    handshake each time), so a short cooldown is no longer the restart-storm
    risk it would have been when everything retried WebRTC. 20s clears a
    transient blip fast without hammering a genuinely persistent outage.
    Co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
    [app.js]
2026-09-06 Camera: fix HLS health check permanently disabling itself after a cooldown-suppressed restart
    Found and confirmed via a real 3-concurrent-viewer stress test run locally
    (nginx now serves DT_LINE directly for exactly this kind of iteration - see
    prior commit): the health check gated its own continued operation on
    hlsActive, and a stall whose restart got suppressed by the 20s cooldown set
    hlsActive = false without ever setting it back - permanently stopping the
    check from running again on every subsequent tick, even though playback
    itself kept working fine after the transient blip passed.
    The check now runs as long as this.hls exists (torn down only in stop()),
    and the healthy-progress branch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
    [app.js]
2026-09-06 Camera: remove WebRTC entirely, HLS-only
    Deliberate architecture decision, not a bug fix - WebRTC's fundamental
    requirement (sustained real-time delivery, zero tolerance for congestion)
    does not fit this connection: ~2 Mbps measured upload, no public IP
    (CGNAT). Every WebRTC failure mode chased tonight - NAT/relay complexity,
    MediaMTX crashing on a saturated write queue, 8-10x bandwidth amplification
    from retransmission on lossy paths, connectionState reporting connected
    while actually broken - traces back to that mismatch, not to
    configuration. HLS's requirements (chunked HTTP, buffered, no real-time
    guarantee) fit what this connection can actually provide.
    - app.js: CAM rewritten HLS-only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
    [app.js]
2026-09-06 Camera: deepen HLS buffer for remote viewers with real round-trip latency
    Reported live: works great on the local network, noticeably weaker over
    the public internet - same encoded stream (identical bitrate/resolution)
    for every viewer, so this isn't a quality difference, it's a margin
    problem. liveSyncDurationCount: 3 (~9s buffer) was tuned to stay close to
    live, which is fine on a low-latency local path but thin for a remote
    viewer: if one segment fetch takes a bit longer than usual over a longer
    round-trip to Cloudflare's edge, playback catches up to its own download
    point and stalls.
    - Client: liveSyncDurationCount 3 -> 6 (~18s), maxBufferLength 20s.
    - Server (mediamtx.yml, Pi-side): hl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
    [app.js]
2026-09-06 camera: reduce HLS live-sync distance from ~18s to ~9s (liveSyncDurationCount 6->3)
    User decision: 20-30s felt too far from live to call it a live feed.
    maxBufferLength stays at 20 (unchanged) so a slow segment fetch still
    has forward-buffer room to recover without forcing a bigger
    steady-state delay - only the live-edge target moved.
    History: this exact liveSyncDurationCount:3 setting previously caused
    remote viewers to stall (their round-trip latency to Cloudflares edge
    could exceed a fetch cycle). Verified against the live production
    stream over the real public path for ~100s with zero stalls before
    committing; longer real-world exposure is the actual test.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
    [app.js]
2026-09-16 Harden the platform tier the application was standing on
    RUNBOOK.md hardened the application and it held. The layer under it had
    no protection at all, and a mains pull on 2026-09-16 destroyed the SD
    card's flash translation layer: the card answers every read with FF, so
    .dt_secret and the whole dt.db incident record are unrecoverable.
    Documents what died with the card, then the prevention: moving root off
    SD, clean shutdown on power loss, a hardware watchdog for kernel hangs,
    write reduction, provisioning as code so a rebuild is 20 minutes, and
    off-card backup. Adds the visibility that was missing too -- read-only
    remount and undervoltage are the symptoms that predict this failure and
    nothi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
2026-09-27 bootstrap: defer the two interactive steps when there is no terminal
    The stated use for this script is an agent running it over SSH, where
    stdin is not a TTY. Both interactive steps misbehave there: `tailscale
    up` prints a login URL and then blocks until somebody visits it, and the
    passphrase `read` takes EOF as an answer without saying so.
    Both now check for a TTY. Tailscale defers with the command to run, and
    the passphrase is left unset -- which is the safe state anyway, since the
    bridge rejects every remote breaker-off while .dt_secret is absent.
2026-09-27 test_stability: [3] failed against a healthy bridge
    Step 3 grepped the journal for "ESP32 -> MQTT". That is a per-packet
    line and journal thinning collapses its repeats, so the check matched
    zero while telemetry was flowing at a measured 1.00 Hz with all three
    brokers connected -- a clean rebuild reported itself broken.
    This is the same stale-string bug already fixed in dt-watchdog.sh, where
    it once restarted the bridge every two minutes; the fix never reached
    the test. Both now key off [SUMMARY], which is printed unconditionally
    every 30 s for exactly this reason.
    The window goes to 35 s to cover one full period, and the check now
    reads the rate and device_online out of the line, so a wed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
2026-09-27 Restore the camera's public path, and make it reproducible this time
    The stream was dark because cloudflared was never reinstalled after the
    card died -- and the old path could not simply be rebuilt: the tunnel
    pointed at a MediaMTX relay on :8888 reached over Tailscale, and that
    relay existed only on the card, described in no file. The dashboard's
    CAM_HLS_URL pointed at a hostname that is not even among the tunnel's
    routes any more.
    So the hop is gone rather than reconstructed. go2rtc already serves HLS,
    so cloudflared now fronts it directly at 127.0.0.1:1984, and the tunnel
    is locally managed: its ingress lives in archive/deploy and is applied
    by bootstrap.sh, instead of sitting in the Cl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
2026-09-27 test_stability: [8] failed against a working camera
    The segment fetch 404'd while the stream was fine -- a tight retry of
    the same three requests pulled 141 KB through the tunnel moments later.
    go2rtc's HLS session id is short-lived and consumed once, so writing the
    playlist to a file and grepping it between requests is enough to lose
    it: the test was measuring its own shell, not the camera.
    The chain now runs with nothing in between, retries three times, and
    checks the leading 0x47 MPEG-TS sync byte rather than trusting a 200 --
    an error page also arrives with a 200 and a plausible length.
2026-09-27 test_stability: check the tunnel and the camera separately
    [8] fetched the public URL from the Pi, which hairpins out to Cloudflare
    and back. It reported FAIL after a cold boot while that same URL was
    serving 144 KB video/mp2t segments to a machine off-site -- the test was
    measuring a path no viewer takes. A combined check also cannot say which
    half broke.
    Now: readyConnections from cloudflared's metrics endpoint answers "is the
    tunnel up from the edge's point of view", and a segment pulled straight
    from go2rtc answers "is there video behind it". Between them the public
    path is implied, and a failure names the half at fault.
    Also fixes the crash when curl -f wrote no file: the checks ran h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
2026-09-27 Watch the platform tier, and tell a human when it fails
    The application tier was thoroughly instrumented while the machine under
    it was not, which is how a mains pull destroyed the card on 2026-09-16
    with nothing watching. The health sampler now records the symptoms that
    precede that failure: fs_readonly (ext4 remounts read-only on error and
    the bridge would otherwise keep running while every write is lost),
    EXT4-fs error counts, and vcgencmd's throttled bits -- undervoltage is
    the one reading here that predicts the failure instead of reporting it,
    because a sagging supply is what makes a power event destructive.
    Recording an incident and telling nobody is the gap this closes.
    recovery_gave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
    [dt_store.py, serial_mqtt_bridge.py]
2026-09-27 test_stability: [9] screamed the card was dying at a healthy filesystem
    The read-only check globbed for "ro," against the whole option list, and
    a healthy root mounts as "rw,noatime,errors=remount-ro,commit=60" -- the
    hardening option contains the pattern, so the check fired on exactly the
    configuration it was written to confirm. The filesystem was rw and
    provably writable at the time.
    A false alarm on the loudest message in the suite is worse than no check:
    it is the same reasoning that removed the always-failing funnel unit.
    Matching the first option field distinguishes a genuinely read-only mount
    from one that merely carries errors=remount-ro. Checked against ro/rw
    lists with and without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
2026-09-27 HARDENING: record what shipped, and what the rebuild did not fix
    18/18 after a cold boot with no manual commands. Writing the status down
    matters most for the part that is still open: the root cause is
    untouched. The Pi still boots from an SD card with no UPS and no clean
    shutdown on power loss, and it is the same card that already proved it
    loses everything on a mains pull. Everything else here reduces the
    damage; only items 1 and 2 prevent the event.
2026-10-27 bootstrap: survive a rebuild when the tunnel outlived its credentials
    A tunnel's credentials JSON is written once, at creation, onto that
    machine only. After the card is lost the tunnel still exists in
    Cloudflare while its credentials do not, and `tunnel create` refuses a
    duplicate name -- so the rebuild found the tunnel, silently failed to
    copy a file that no longer existed, and started a connector that could
    not authenticate.
    It now detects the missing credentials, deletes the orphaned tunnel and
    creates a fresh one; the name and the DNS record are what matter and the
    id is disposable. The DNS route is applied with --overwrite-dns, since
    after a recreate the CNAME still points at the dead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
2026-10-27 install: stop warning about a unit that is meant to be absent
    The camera-autostart check still looked for tailscale-funnel.service,
    which was removed when the stream moved to the Cloudflare Tunnel. Every
    rebuild therefore ended on a scary warning about a unit nobody wants,
    and a warning that is always wrong is a warning everyone learns to skip.
